gfedorkow/Micro-Whirlwind/README.md

Schematic and printed circuit KiCad design files for a hand-held Whirlwind emulator based on the Raspberry Pi
