gfedorkow/Micro-Whirlwind/Notes/RasPi5-Hardware-Notes.odt

RasPi Connector Pinout

Pin | Name | To/From Pi | owner | Use
1 | 3.3V | From | | -
2 | 5V | From | | -
3 | GPIO2 / SDA1 | BiDir | Both | I2C SDA
4 | 5V | From | | -
5 | GPIO3 / SCL1 | From | Both | I2C SCL
6 | GND | From | | -
7 | GPIO4 | To | RG | isGun1On – signals that the Gun1 trigger is pulled
8 | GPIO14, TXD
9 | GND | From | | -
10 | GPIO15, RXD | To
11 | GPIO17 | ? | RG | gfx doMove;
12 | GPIO18 | From | RG | enZ1 – Scope 1 Intensity
13 | GPIO27 | To | RG | isButton – application interrupt signal
14 | GND | From | | -
15 | GPIO22 | From | RG | gfx doDraw
16 | GPIO23 | From | RG | enZ2 – Scope 2 Intensity
17 | 3.3V | From | | -
18 | GPIO24 | To | RG | isGun2Pulse – single pulse per trigger pull
19 | GPIO10 / SPI-MOSI | From | RG | SPI MOSI
20 | GND | From | | -
21 | GPIO9 / SPI-MISO | To | RG | SPI-MISO
22 | GPIO25 | To | RG | isGun1Pulse – single pulse per trigger pull
23 | GPIO11 SPI-SCLK | From | RG | SPI-CLK
24 | GPIO8 / SPI_CE0 | From | RG | SPI Select for DAC
25 | GND | To | | -
26 | GPIO7 / SPI-CE1 | To | RG | isGun2On – signals that the Gun2 trigger is pulled
27 | ID_SD | | | -
28 | ID_SC | | | -
29 | GPIO5 | BiDir | RG | GPIO05 – toggle switch
30 | GND | From | | -
31 | GPIO6 | BiDir | RG | GPIO06 – toggle switch
32 | GPIO12 | | | Spare!
33 | GPIO13 | To | GF | Power control input
34 | GND | | | -
35 | GPIO19 | From | GF | Power control output
36 | GPIO16 | To | GF | Key Scanner Interrupt
37 | GPIO26 | To | GF | Key Scanner Reset
38 | GPIO20 | BiDir | RG | GPIO20 – toggle switch
39 | GND | From | | -
40 | GPIO21 | BiDir | RG | GPIO21 – toggle switch

Address Map

Lights / IS31FL Drivers

I2C | Row Addr aka Frame | Bits | Ref Des | Function
74 | 0 | 7:0 | | MAR
| | 15:8

Power shutdown button

https://forums.raspberrypi.com/viewtopic.php?t=371129

dtoverlay=gpio-shutdown,gpio_pin=15

gpio=23=op,dh

RetArsonFD (https://forums.raspberrypi.com/memberlist.php?mode=viewprofile&u=360628&sid=c77f70ce02d40ed3e05a03a25251eb3e)

Posts: 9 (https://forums.raspberrypi.com/search.php?author_id=360628&sid=c77f70ce02d40ed3e05a03a25251eb3e)

Joined: Sun Jan 03, 2021 3:49 pm

### Re: How to do a soft shutdown on headless Pi? (https://forums.raspberrypi.com/viewtopic.php?t=306320#p1832670)

Mon Mar 08, 2021 12:58 pm (https://forums.raspberrypi.com/viewtopic.php?p=1832670&sid=c77f70ce02d40ed3e05a03a25251eb3e#p1832670)

RonR (https://forums.raspberrypi.com/memberlist.php?mode=viewprofile&u=186692&sid=c77f70ce02d40ed3e05a03a25251eb3e) wrote: ↑ (https://forums.raspberrypi.com/viewtopic.php?p=1832522&sid=c77f70ce02d40ed3e05a03a25251eb3e#p1832522)

Mon Mar 08, 2021 4:46 am

Another option is to connect a Normally Open (NO) Single Pole Single Throw (SPST) momentary pushbutton switch to GPIO header pins 5 and 6 on the Raspberry Pi and add the following line to /boot/config.txt:

Code: Select all (https://forums.raspberrypi.com/viewtopic.php?t=306320#)

dtoverlay=gpio-shutdown

Pressing the button on a running system will initiate a graceful shutdown (shutdown -h now). Watch for the green LED to blink 10 times and it's safe to turn off the power. If you don't turn off the power, pressing the button again will restart the system.

(https://forums.raspberrypi.com/memberlist.php?mode=viewprofile&u=119273&sid=c77f70ce02d40ed3e05a03a25251eb3e)

B.Goode (https://forums.raspberrypi.com/memberlist.php?mode=viewprofile&u=119273&sid=c77f70ce02d40ed3e05a03a25251eb3e)

Posts: 17352 (https://forums.raspberrypi.com/search.php?author_id=119273&sid=c77f70ce02d40ed3e05a03a25251eb3e)

Joined: Mon Sep 01, 2014 4:03 pm

Location: UK

### Re: How to do a soft shutdown on headless Pi? (https://forums.raspberrypi.com/viewtopic.php?t=306320#p1832684)

Mon Mar 08, 2021 1:26 pm (https://forums.raspberrypi.com/viewtopic.php?p=1832684&sid=c77f70ce02d40ed3e05a03a25251eb3e#p1832684)

RetArsonFD (https://forums.raspberrypi.com/memberlist.php?mode=viewprofile&u=360628&sid=c77f70ce02d40ed3e05a03a25251eb3e) wrote: ↑ (https://forums.raspberrypi.com/viewtopic.php?p=1832670&sid=c77f70ce02d40ed3e05a03a25251eb3e#p1832670)

Mon Mar 08, 2021 12:58 pm

Where would I put the "dtoverlay=gpio-shutdown" command ? If I remember what I've been told, there are numbered lines in the config txt ??

No. The format of the config.txt file is documented here. It is not numbered. https://www.raspberrypi.org/documentati ... /README.md (https://www.raspberrypi.org/documentation/configuration/config-txt/README.md)


The specific details of the dtoverlay=gpio-shutdown configuration option are here - https://raw.githubusercontent.com/raspb ... ays/README

Quote from the above link:

Name: gpio-shutdown

Info: Initiates a shutdown when GPIO pin changes. The given GPIO pin

is configured as an input key that generates KEY_POWER events.

This event is handled by systemd-logind by initiating a

shutdown. Systemd versions older than 225 need an udev rule

enable listening to the input device:

ACTION!="REMOVE", SUBSYSTEM=="input", KERNEL=="event*", \

SUBSYSTEMS=="platform", DRIVERS=="gpio-keys", \

ATTRS{keys}=="116", TAG+="power-switch"

Alternatively this event can be handled also on systems without

systemd, just by traditional SysV init daemon. KEY_POWER event

(keycode 116) needs to be mapped to KeyboardSignal on console

and then kb::kbrequest inittab action which is triggered by

KeyboardSignal from console can be configured to issue system

shutdown. Steps for this configuration are:

Add following lines to the /etc/console-setup/remap.inc file:

# Key Power as special keypress

keycode 116 = KeyboardSignal

Then add following lines to /etc/inittab file:

# Action on special keypress (Key Power)

kb::kbrequest:/sbin/shutdown -t1 -a -h -P now

And finally reload configuration by calling following commands:

# dpkg-reconfigure console-setup

# service console-setup reload

# init q

This overlay only handles shutdown. After shutdown, the system

can be powered up again by driving GPIO3 low. The default

configuration uses GPIO3 with a pullup, so if you connect a

button between GPIO3 and GND (pin 5 and 6 on the 40-pin header),

you get a shutdown and power-up button. Please note that

Raspberry Pi 1 Model B rev 1 uses GPIO1 instead of GPIO3.

Load: dtoverlay=gpio-shutdown,<param>=<val>

Params: gpio_pin GPIO pin to trigger on (default 3)

For Raspberry Pi 1 Model B rev 1 set this

explicitly to value 1, e.g.:

dtoverlay=gpio-shutdown,gpio_pin=1

active_low When this is 1 (active low), a falling

edge generates a key down event and a

rising edge generates a key up event.

When this is 0 (active high), this is

reversed. The default is 1 (active low).

gpio_pull Desired pull-up/down state (off, down, up)

Default is "up".

Note that the default pin (GPIO3) has an

external pullup. Same applies for GPIO1

on Raspberry Pi 1 Model B rev 1.

debounce Specify the debounce interval in milliseconds

(default 100)
