gfedorkow/Micro-Whirlwind/KiCad-PCB/Micro-Whirlwind-Main-PCB - As-Built Dec-2024/parts-list.xlsx

vendor part # | vendor | digikey part# | mouser part # | Description
ILS TB180 40 |  |  |  | Blue LED push switch
