gfedorkow/Micro-Whirlwind/KiCad-PCB/Micro-Whirlwind-Main-PCB - As-Built Dec-2024/Micro-Whirlwind-Main-PCB-guy.xlsx

Reference | Value | Datasheet | Footprint | Qty | DNP | Digi-Key | Mouser
C1,C2,C3 | C | ~ | Capacitor_THT:C_Rect_L7.0mm_W2.5mm_P5.00mm | 3
C4 | 47uF | ~ | Capacitor_THT:CP_Radial_D5.0mm_P2.50mm | 1 |  | 478-7383-1-ND
C5,C7,C8,C9,C10,C11 | 0.1uF | ~ | Capacitor_THT:C_Rect_L7.0mm_W2.5mm_P5.00mm | 6
C6 | 47uf | ~ | Capacitor_THT:CP_Radial_D5.0mm_P2.50mm | 1
D1,D2,D3,D4,D5,D6,D7,D8,D9,D10,D11,D12,D17,D18 | LED | ~ | LED_THT:LED_D3.0mm | 14
F1 | Polyfuse | ~ | Fuse:Fuse_Bourns_MF-RG300 | 1 |  | MF-RG300-0-ND
J1,J2 | Conn_02x08_Odd_Even | https://mm.digikey.com/Volume0/opasdata/d220001/medias/docus/6025/302-S.pdf | -- mixed values -- | 2 |  | ED10523-ND, ED10535-ND straight & right-angle
J4,J8 | Conn_01x03 | https://www.molex.com/pdm_docs/sd/022122034_sd.pdf | mWW-Project-Library:PSS_3 | 2 |  | WM2712-ND
J5 | X | ~ | mWW-Project-Library:CUI_RCJ-041 | 1 |  | CP-1418-ND
J6 | Y | ~ | mWW-Project-Library:CUI_RCJ-041 | 1 |  | CP-1418-ND
J7 | Z | ~ | mWW-Project-Library:CUI_RCJ-041 | 1 |  | CP-1418-ND
J9 | RaspiGPIO40 | https://multimedia.3m.com/mws/media/330367O/3m-four-wall-header-2500-series-ts-0770.pdf | Connector_PinHeader_2.54mm:PinHeader_2x20_P2.54mm_Vertical | 1 |  | MHC40E-ND
L1,LCD1,mD1,mD2,mD3,mD4,mD5,mD6,mD7,mD8,mD9,mD10,mD11,mD12,mD13,mD14,mD15,mD16,mD17,mD18,mD19,mD20,U7 | ~ |  | -- mixed values -- | 23 |  | Elecrow LCD DigiKey part = 5131-DIS00005R-ND
R1,R2,R3,R4,R5,R6,R7,R8 | R | ~ | mWW-Project-Library:SM-1206B | 8
R9,R10 | 6.8k | ~ | mWW-Project-Library:SM-1206B | 2
RV1,RV2 | 10k | ~ | Potentiometer_THT:Potentiometer_Bourns_PTV09A-2_Single_Horizontal | 2 |  | 118-PTV09A-2015U-B103-ND
S3,S4 | RA_Push | https://www.ckswitches.com/media/1457/ksa_ksl.pdf | mWW-Project-Library:SW_KSA0V311LFTR_CNK-RA-pushbutton | 2 |  | CKN10736-ND
SW1,SW2,SW3,SW4,SW5,SW18,SW19,SW20,SW21,SW22 | mSW_Push_LEDx8 | https://www.ckswitches.com/media/2865/ils.pdf | mWW-Project-Library:mILS-TB-140-SW_PUSH_and_LED_6mm_x8 | 10 |  | 108-ILSTB18040-ND
 |  |  | white square cap |  |  | 108-ILSCAPS757502-ND
 |  |  | round switch cap |  |  | 108-ILSCAPR0691-ND
SW6,SW7,SW8,SW9,SW10,SW11,SW12,SW13,SW14,SW15,SW23,SW24,SW28,SW29,SW30,SW31,SW32,SW33,SW34,SW35,SW36,SW37,SW38,SW39,SW40 | SW_Push_LED | ~ | -- mixed values -- | 25
SW25 | SW_SPDT_MSM |  | mWW-Project-Library:SPDT-Toggle-Right-Angle-Vertical | 1 |  | can't find one… | https://www.mouser.com/ProductDetail/Apem/5239AB?qs=RvImgz6LUSWFeoa22Cgj3Q%3D%3D
U1,U2,U5 | IS31FL3731-SA | http://www.issi.com/WW/pdf/31FL3731.pdf | Package_SO:SSOP-28_5.3x10.2mm_P0.65mm | 3
U3,U4 | TCA8418RTWR |  | mWW-Project-Library:QFN50P400X400X80-25N | 2
U6 | LTC4316IDD_PBF |  | mWW-Project-Library:DFN-10_DD | 1 |  | 505-LTC4316CMS#PBF-ND
U8 | RasPi Outline |  | mWW-Project-Library:RasPi-Outline | 1 |  | n/a
U9 | D_to_A_Outline |  | mWW-Project-Library:D_to_A_Outline | 1 |  | n/a
U10 | 4001 | http://www.intersil.com/content/dam/Intersil/documents/cd40/cd4000bms-01bms-02bms-25bms.pdf | Package_SO:SOIC-14_3.9x8.7mm_P1.27mm | 1 |  | 296-3500-5-ND
 | cd4106BM |  | SOIC - schmidt trigger |  |  | 296-25935-5-ND
 | NKK B12JP spdt toggle sw | https://www.nkkswitches.com/pdf/Btoggles.pdf |  |  |  | 360-3783-ND
 | IRF5305PBF |  | p-channel mosfet |  |  | 4518-IRF5305PBF-ND
 | 3.5 mm audio jack | https://www.sameskydevices.com/product/resource/sj1-353xng.pdf |  |  |  | CP1-3535NG-ND
