gfedorkow/Micro-Whirlwind/Data-Sheets/IF31FL3731_LED_Wiring.pdf

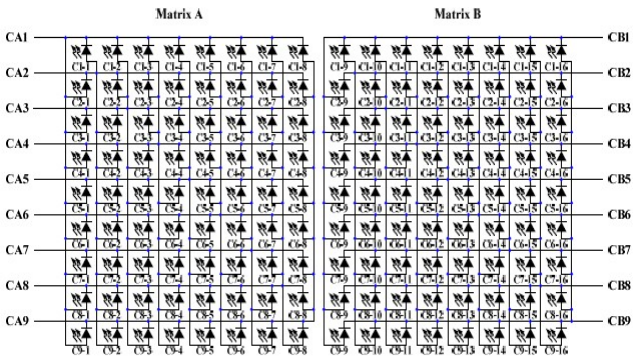
[picture p4: figure]
