gfedorkow/Micro-Whirlwind/KiCad-PCB/panel-sketch-8mm-keys.pdf

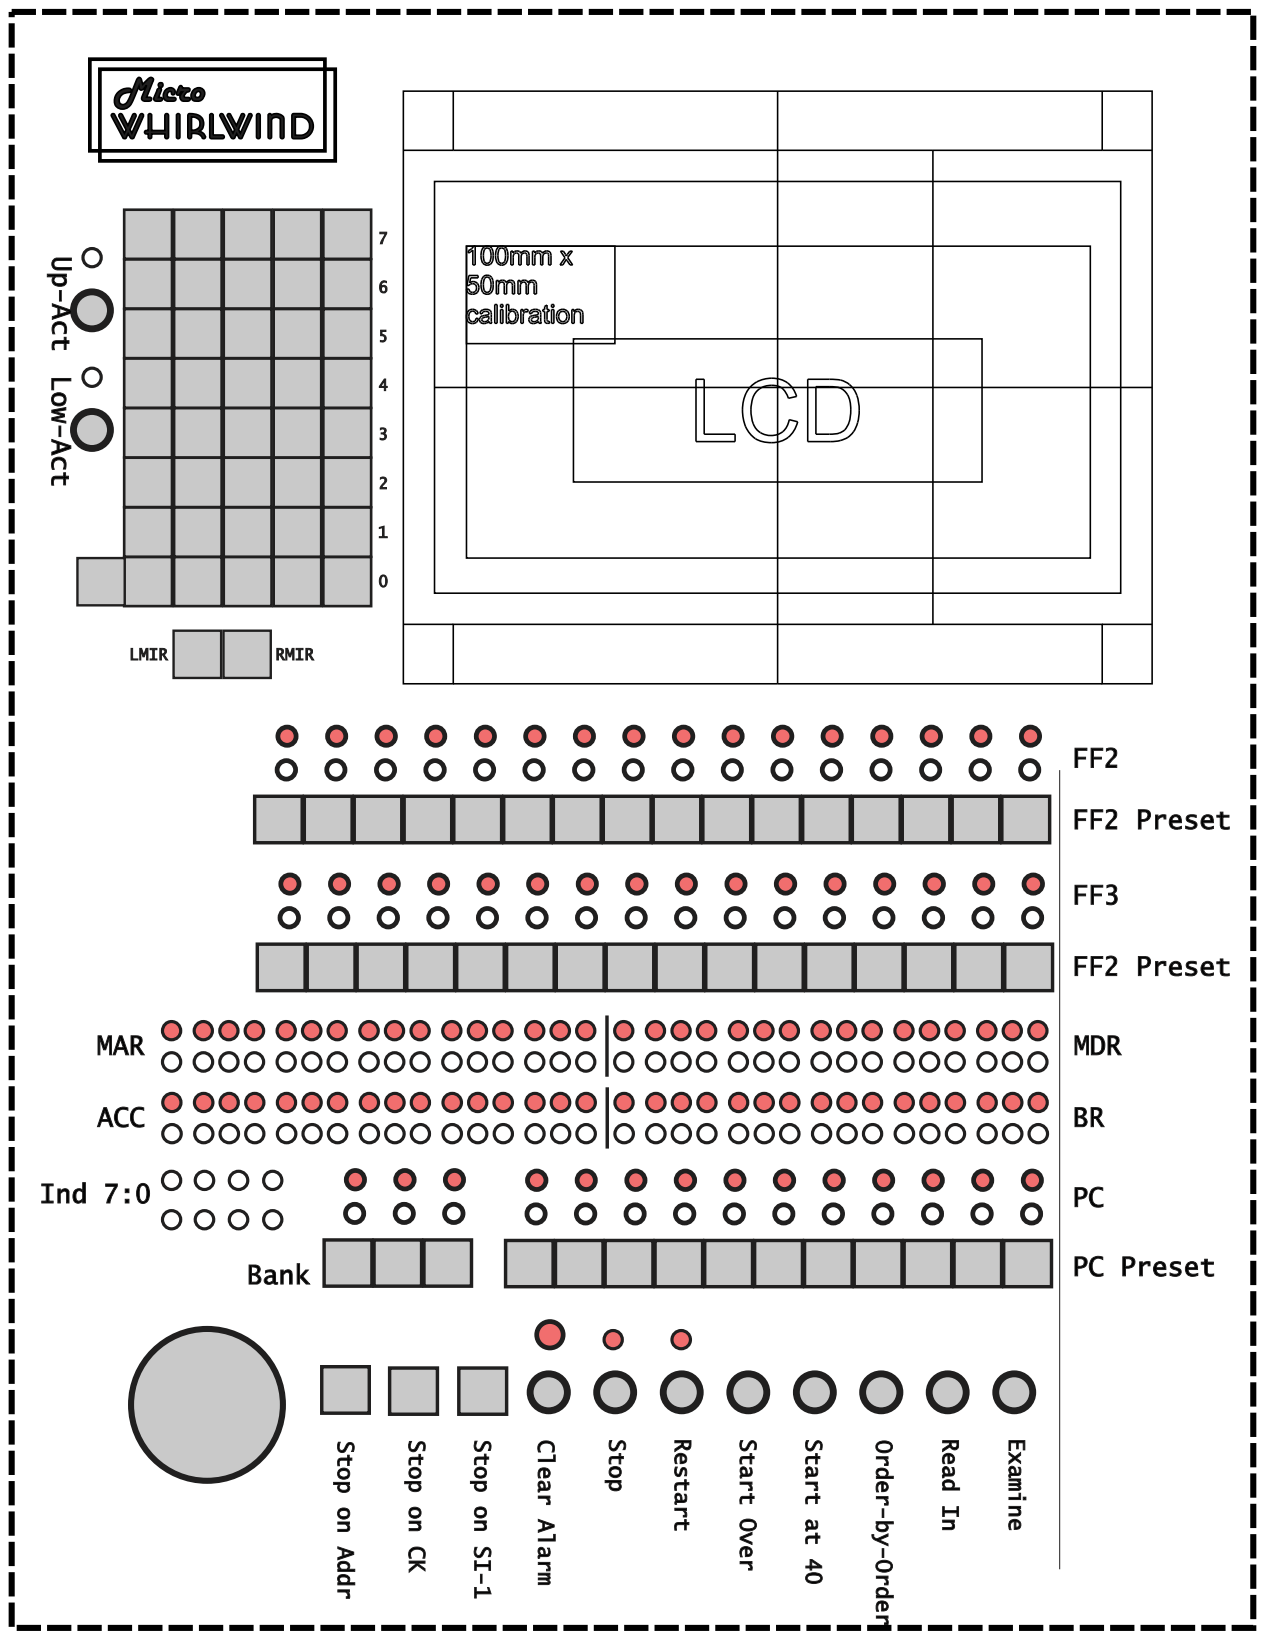
[picture p5: page 1]
