gfedorkow/Micro-Whirlwind/KiCad-PCB/Micro-Whirlwind-Dress-Panel/trial-silk-Dec14-2024.pdf

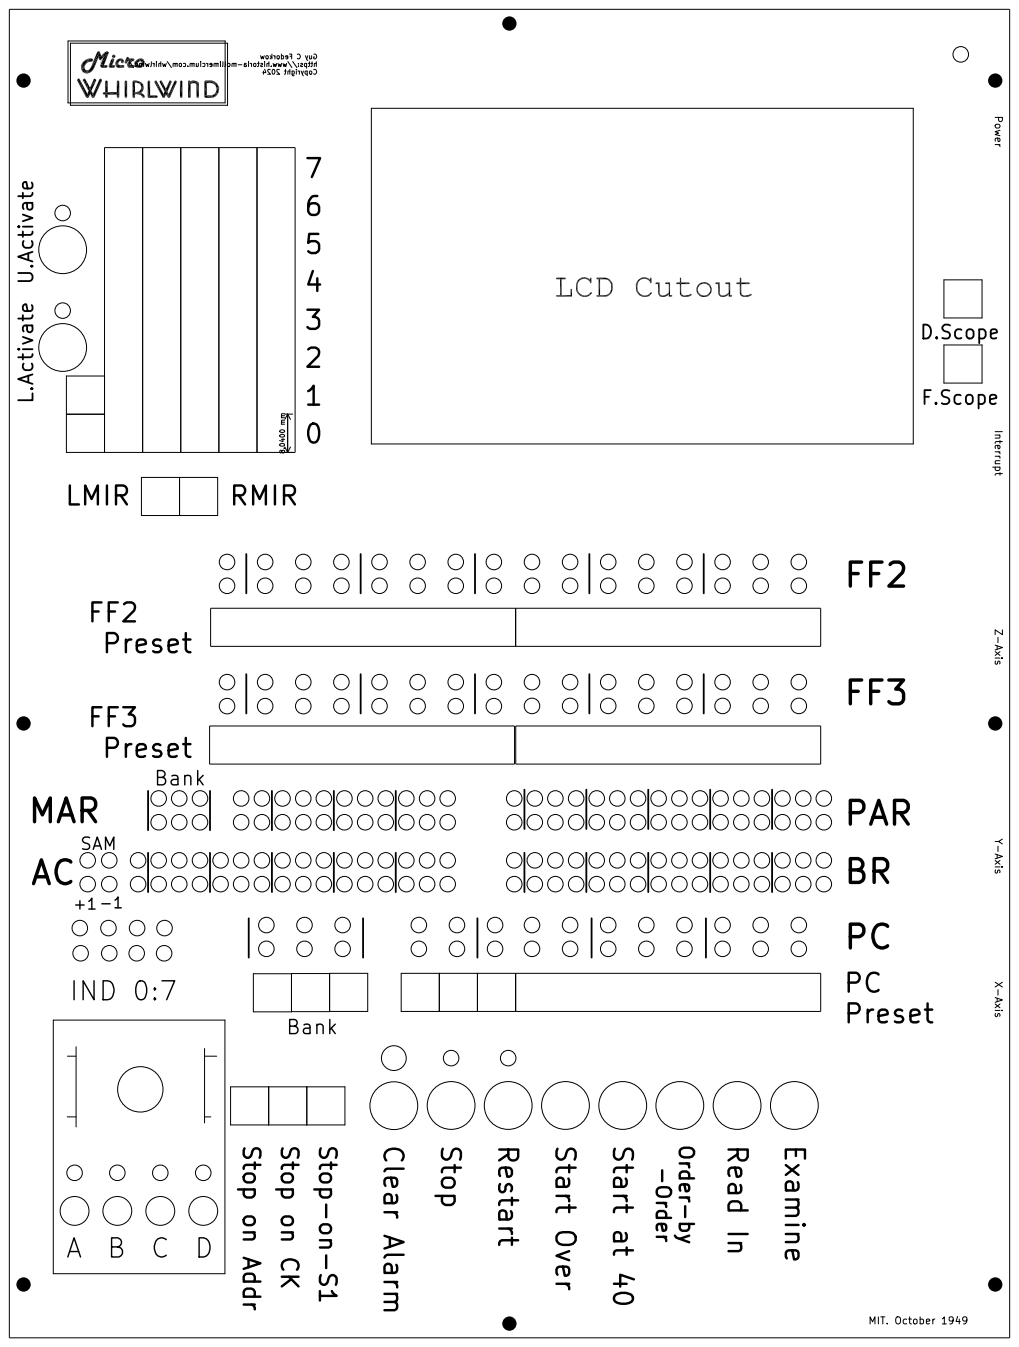
[picture p6: page 1]
