gfedorkow/Micro-Whirlwind/KiCad-PCB/Micro-Whirlwind-Dress-Panel/trial-silk-Dec15-2024.pdf

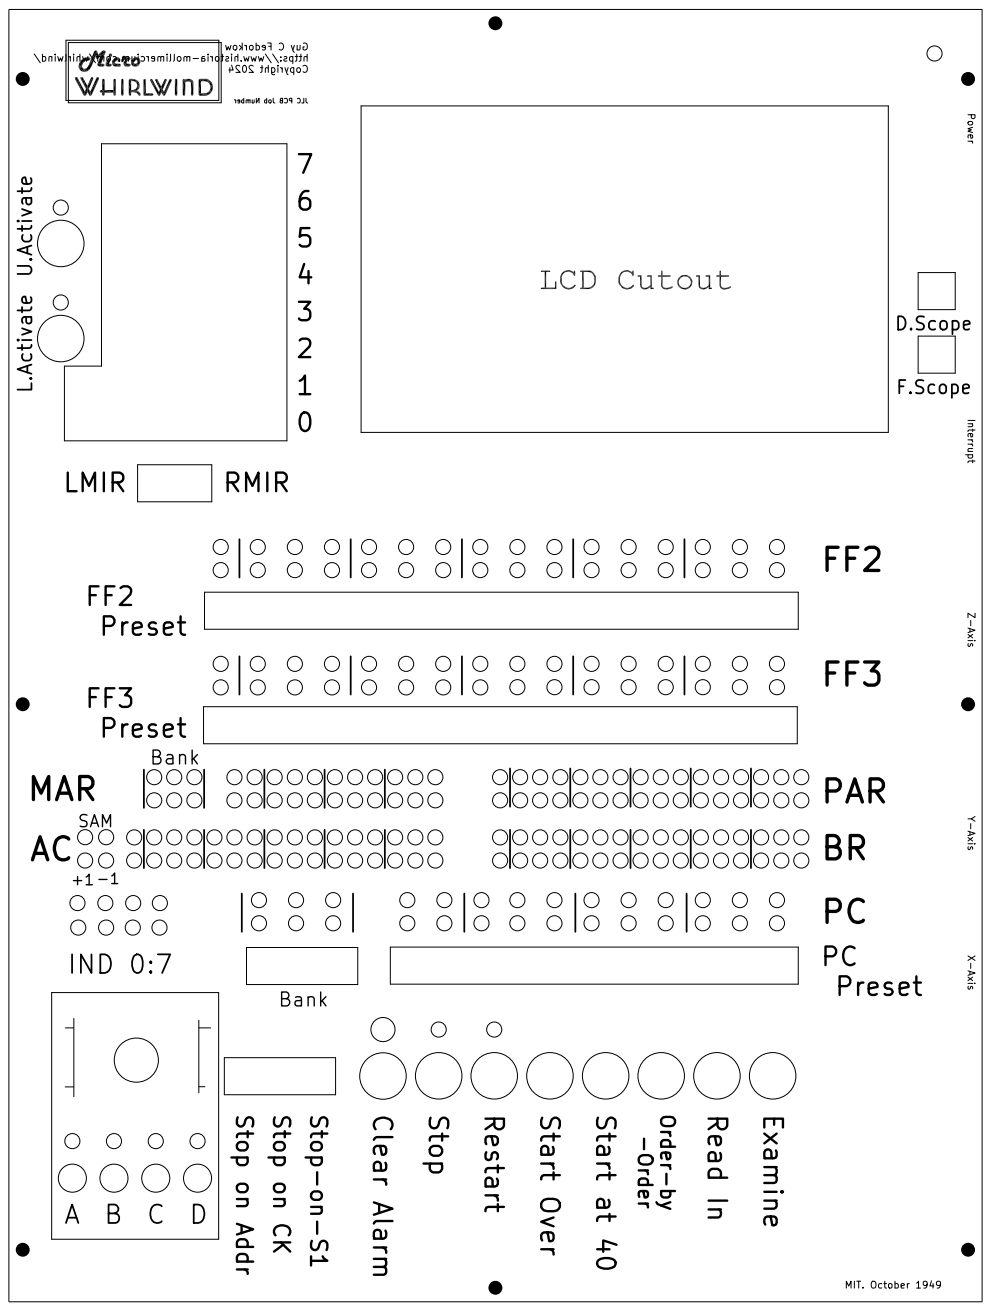
[picture p7: page 1]
