gfedorkow/Micro-Whirlwind/KiCad-PCB/Micro-Whirlwind-Main-PCB/trial-silk-screen-dec08-2024.pdf

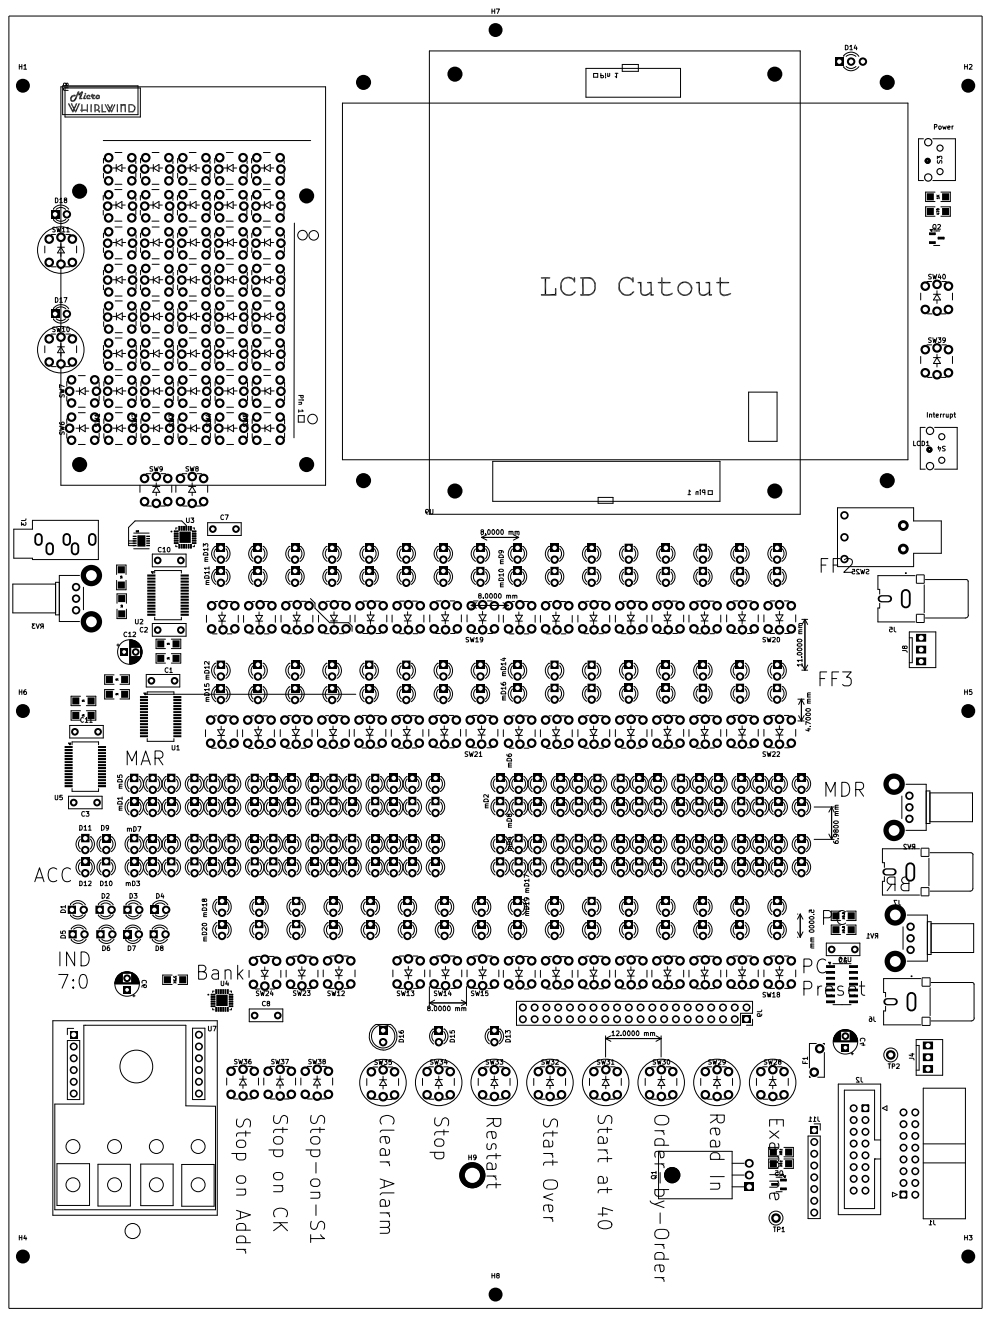
[picture p8: page 1]
