gfedorkow/Micro-Whirlwind/KiCad-PCB/Micro-Whirlwind-Main-PCB/trial-silk-screen-dec15-2024.pdf

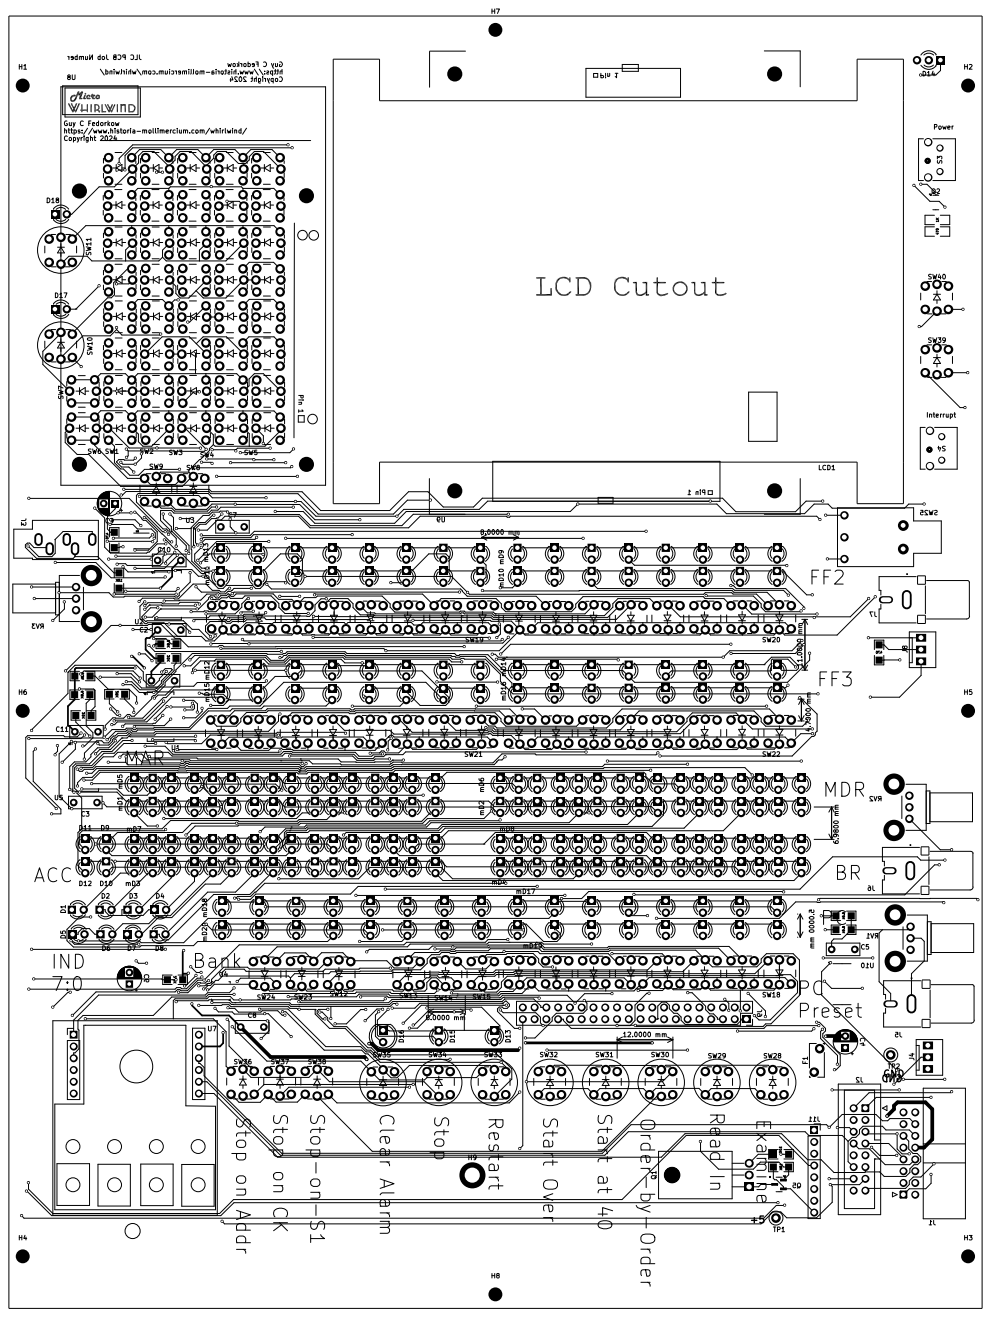
[picture p9: page 1]
