gfedorkow/Micro-Whirlwind/KiCad-PCB/Micro-Whirlwind-Rotary-Daughter/rotary-daughter-silk-dec12-2024.pdf

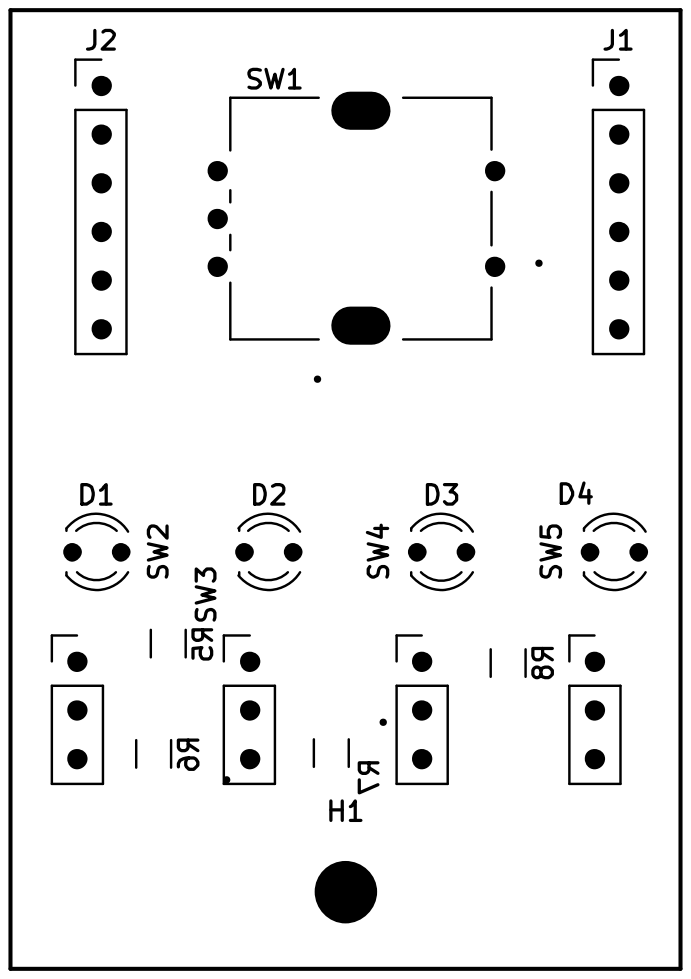
[picture p10: page 1]
