gfedorkow/Micro-Whirlwind/KiCad-PCB/Micro-Whirlwind-Main-PCB - As-Built Dec-2024/Micro-Whirlwind-Main-PCB.kicad_pcb

## KiCad design KiCad-PCB/Micro-Whirlwind-Main-PCB - As-Built Dec-2024/Micro-Whirlwind-Main-PCB.kicad_pcb (2025-10-29)

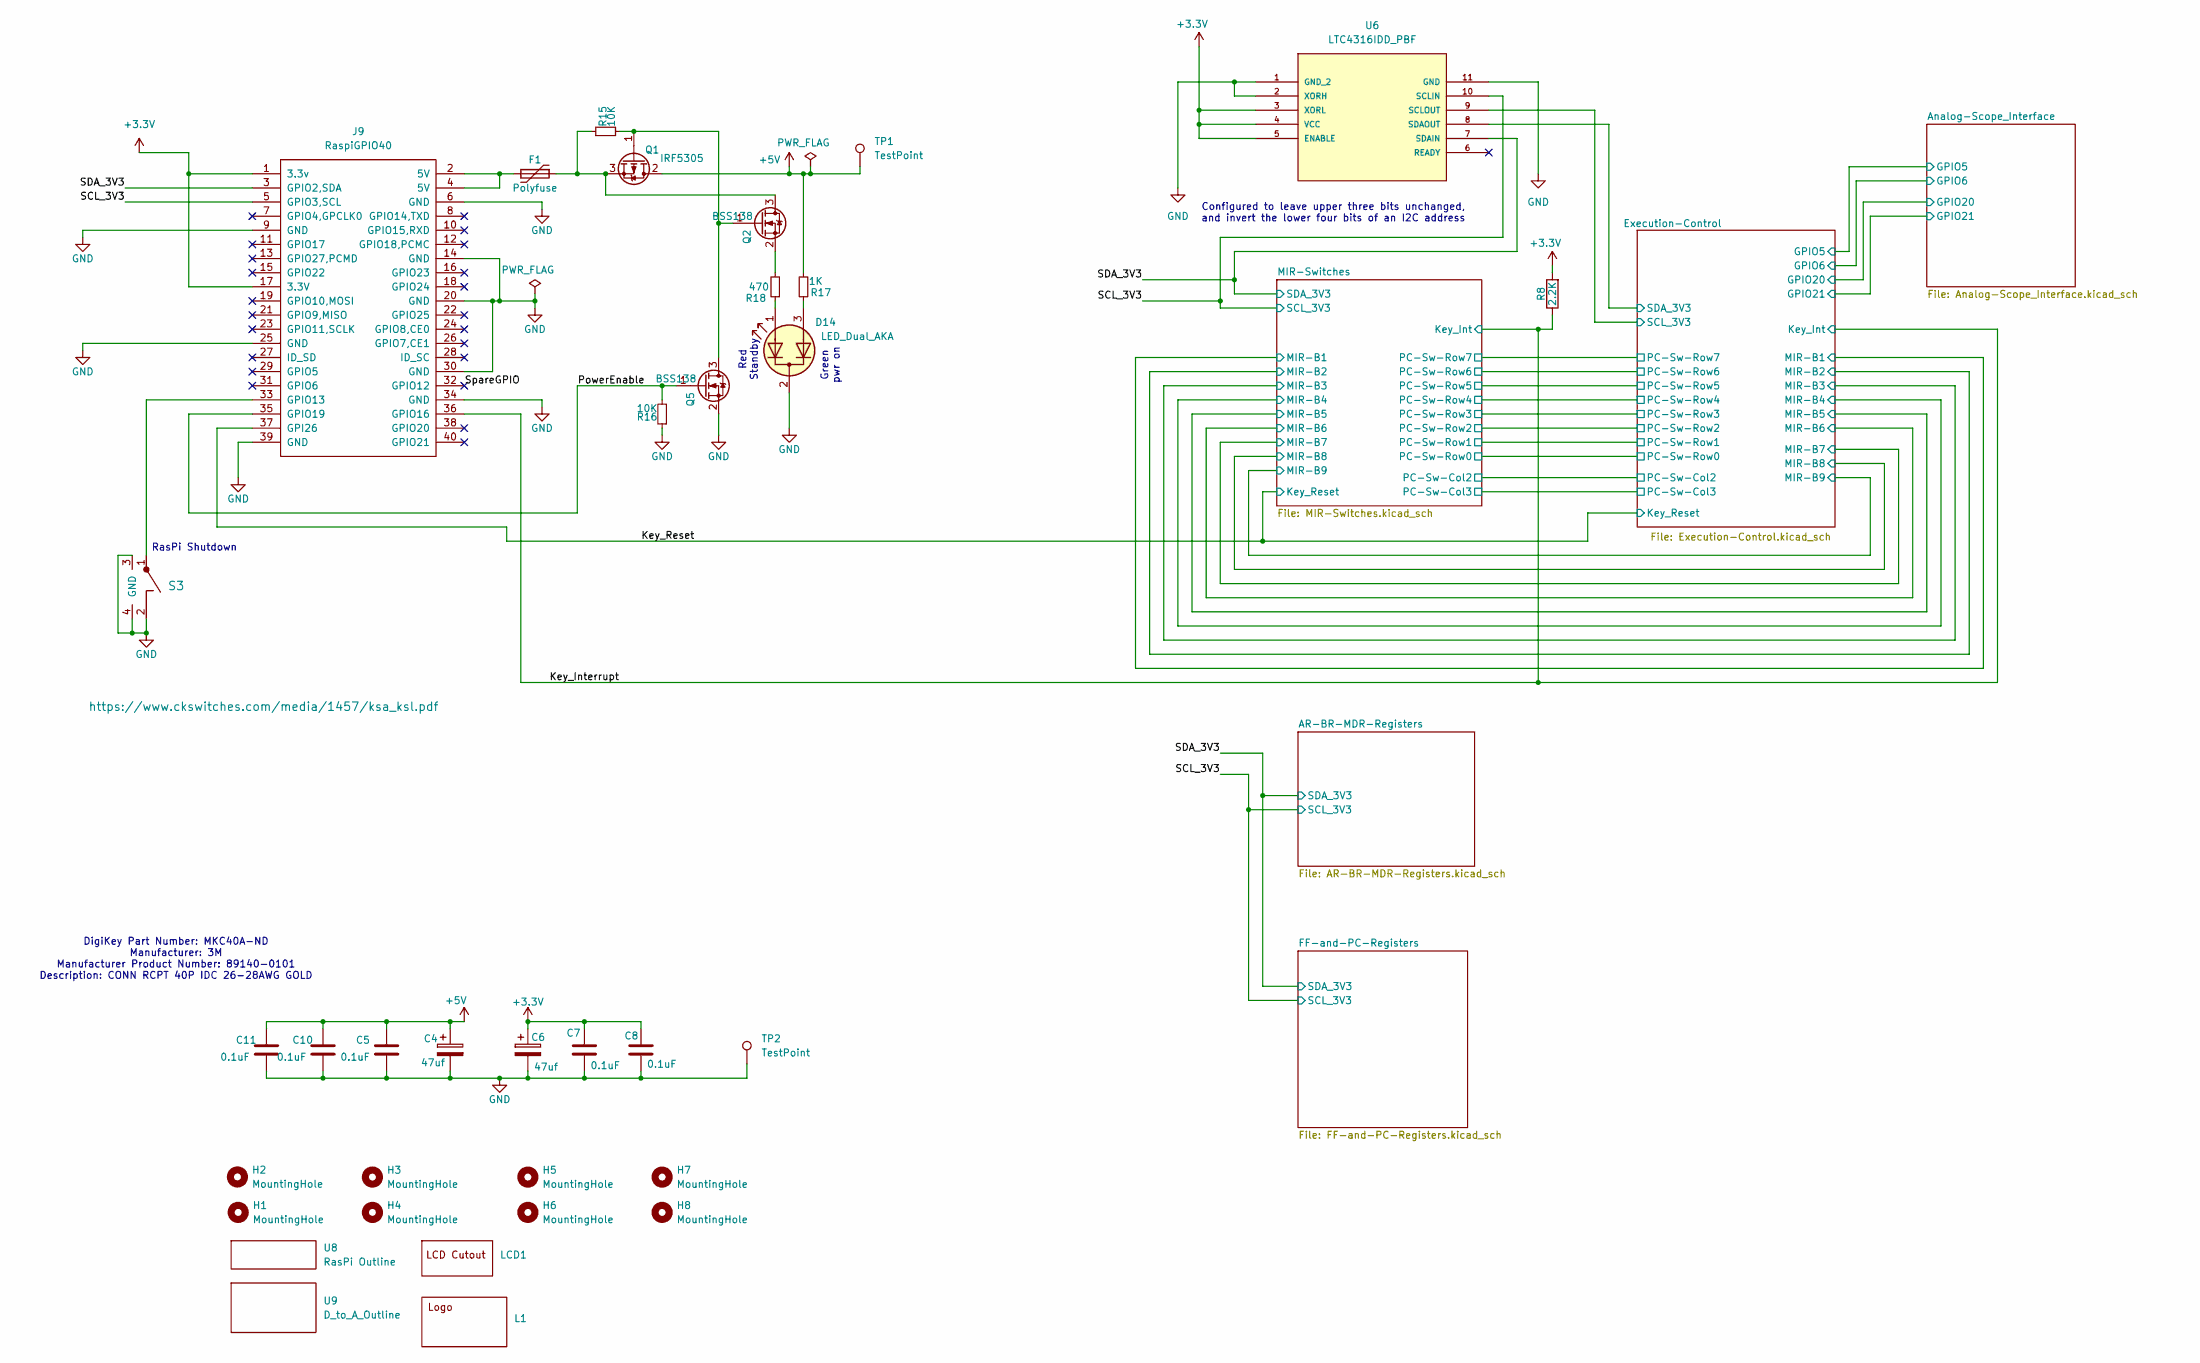
[picture p11: schematic Micro-Whirlwind-Main-PCB.kicad_sch]

Parts:
C4, C6: 47uf; CP_Radial_D5.0mm_P2.50mm
C5, C7, C8, C10, C11: 0.1uF; C_Rect_L7.0mm_W2.5mm_P5.00mm
D14: LED_Dual_AKA; LED_D3.0mm-3
F1: Polyfuse; Fuse_Bourns_MF-RG300
H1, H2, H3, H4, H5, H6, H7, H8: MountingHole; MountingHole_4_40_body
J9: RaspiGPIO40; PinHeader_2x20_P2.54mm_Vertical
L1: Logo-Large
LCD1: LCD-Cutout
Q1: IRF5305; TO-220-3_Horizontal_TabDown
Q2, Q5: BSS138; SOT-23
R8: 2.2K; SM-1206B
R15, R16: 10K; SM-1206B
R17: 1K; SM-1206B
R18: 470; SM-1206B
S3: RA_Push; SW_KSA0V311LFTR_CNK-RA-pushbutton
TP1, TP2: TestPoint; TestPoint_Loop_D2.50mm_Drill1.0mm
U6: LTC4316IDD_PBF; DFN-10_DD-with-clearance; MANUFACTURER_PART_NUMBER ltc4316idd#pbf
U8: RasPi Outline; RasPi-Outline
U9: D_to_A_Outline

Connections:
+3.3V: C6.1, C7.1, C8.1, J9.1 (3.3v), J9.17 (3.3V), R8.2, U6.3 (XORL), U6.4 (VCC), U6.5 (ENABLE); also elsewhere on the board
+5V: C4.1, C5.1, C10.1, C11.1, Q1.2 (D), R17.2, TP1.1; also elsewhere on the board
/Execution-Control/SCL_3V3: U6.9 (SCLOUT); also elsewhere on the board
/Execution-Control/SDA_3V3: U6.8 (SDAOUT); also elsewhere on the board
/Key_Interrupt: J9.36 (GPIO16), R8.1; also elsewhere on the board
/Key_Reset: J9.37 (GPI26); also elsewhere on the board
/PowerEnable: J9.35 (GPIO19), Q5.1 (G), R16.2
/SCL_3V3: J9.5 (GPIO3,SCL), U6.10 (SCLIN); also elsewhere on the board
/SDA_3V3: J9.3 (GPIO2,SDA), U6.7 (SDAIN); also elsewhere on the board
/SpareGPIO: J9.32 (GPIO12)
GND: C4.2, C5.2, C6.2, C7.2, C8.2, C10.2, C11.2, D14.2 (K), J9.6 (GND), J9.9 (GND), J9.14 (GND), J9.20 (GND), J9.25 (GND), J9.30 (GND), J9.34 (GND), J9.39 (GND), Q5.2 (S), R16.1, S3.2, S3.3 (GND), S3.4, TP2.1, U6.1 (GND_2), U6.2 (XORH), U6.11 (GND); also elsewhere on the board
unnamed: D14.1 (A1), R18.1
unnamed: D14.3 (A2), R17.1
unnamed: F1.2, J9.2 (5V), J9.4 (5V)
unnamed: J9.33 (GPIO13), S3.1
unnamed: Q1.1 (G), Q2.1 (G), Q5.3 (D), R15.2
unnamed: F1.1, Q1.3 (S), Q2.3 (D), R15.1
unnamed: Q2.2 (S), R18.2

Notes on the sheet:
Green pwr on
DigiKey Part Number: MKC40A-ND Manufacturer: 3M Manufacturer Product Number: 89140-0101 Description: CONN RCPT 40P IDC 26-28AWG GOLD
Configured to leave upper three bits unchanged, and invert the lower four bits of an I2C address
Red Standby
RasPi Shutdown

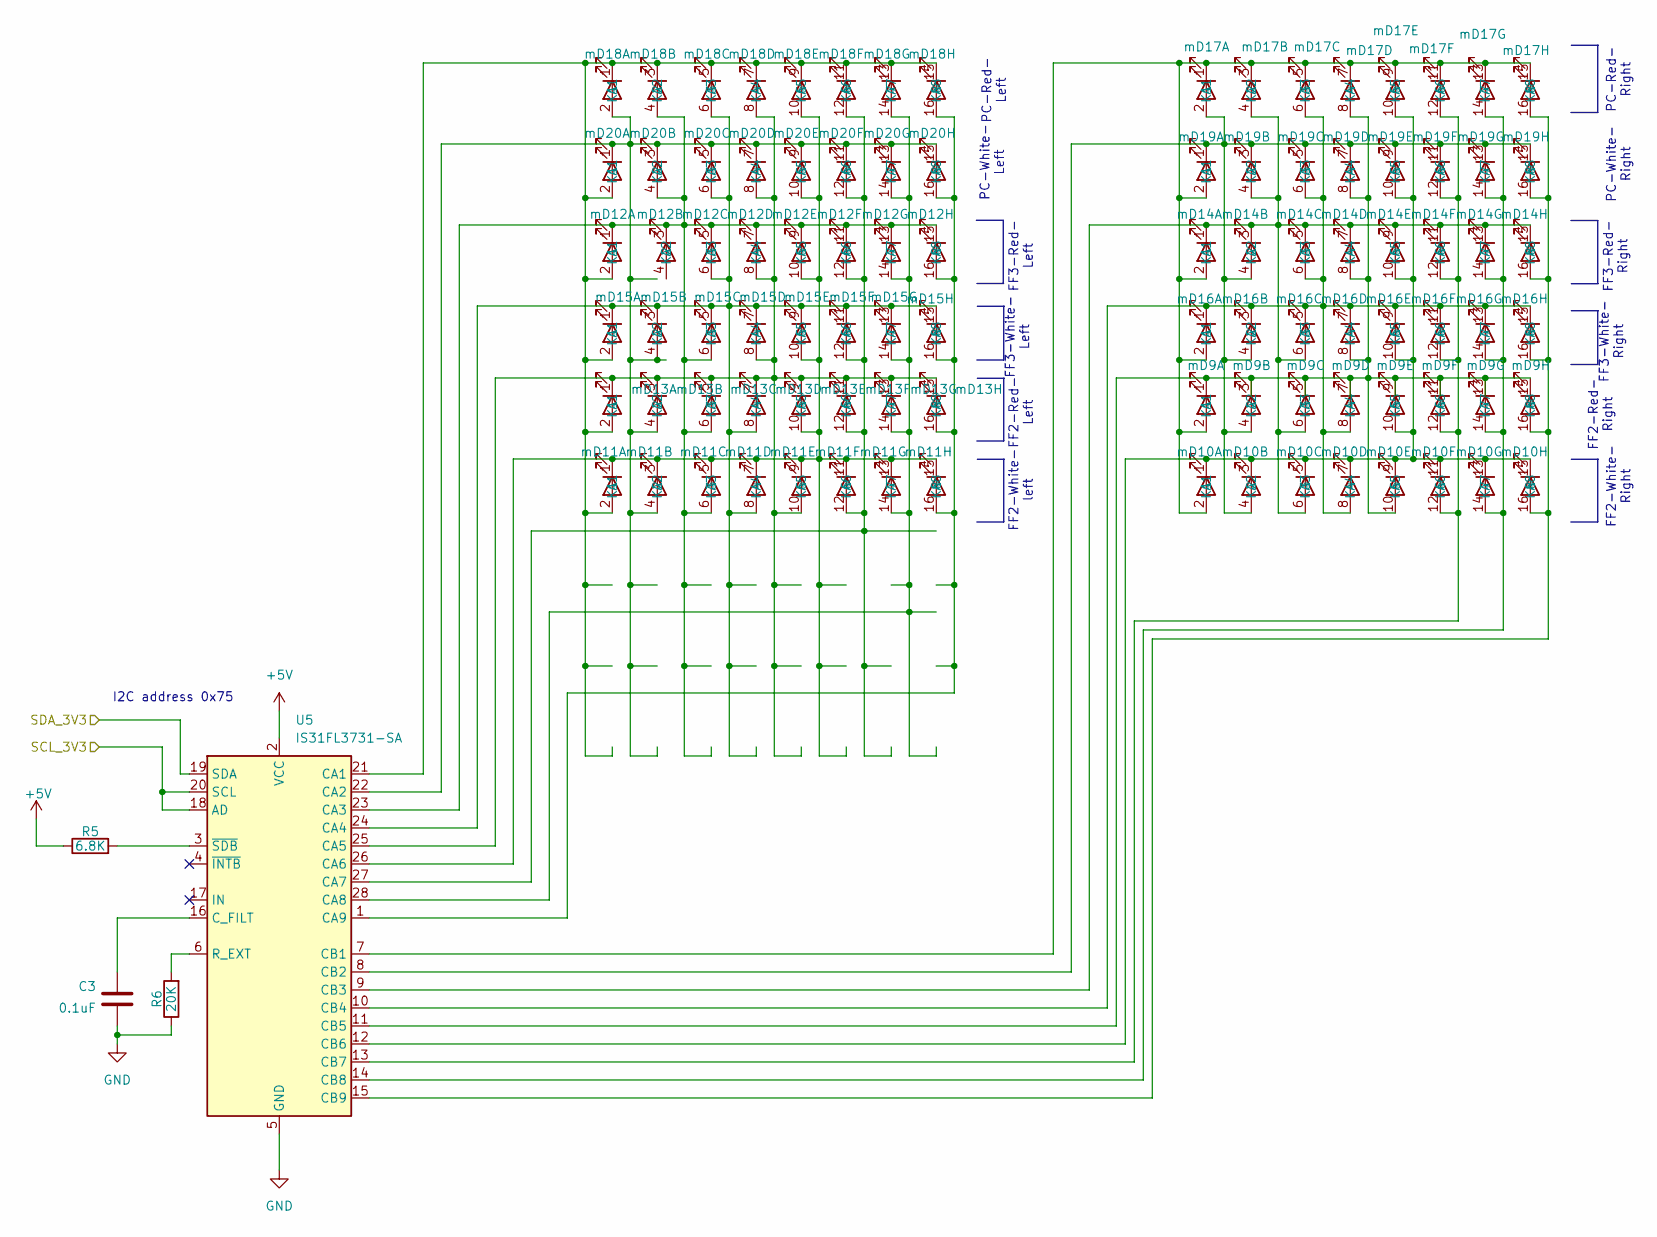
[picture p12: schematic FF-and-PC-Registers.kicad_sch]

Parts:
C3: 0.1uF; C_Rect_L7.0mm_W2.5mm_P5.00mm
R5: 6.8K; SM-1206B
R6: 20K; SM-1206B
U5: IS31FL3731-SA; SSOP-28_5.3x10.2mm_P0.65mm
mD9, mD10, mD11, mD12, mD13, mD14, mD15, mD16, mD17, mD18, mD19, mD20: LED_D3.0mm_8x_bank

Connections:
+5V: R5.1, U5.2 (VCC); also elsewhere on the board
/SCL_3V3: U5.18 (AD), U5.20 (SCL); also elsewhere on the board
/SDA_3V3: U5.19 (SDA); also elsewhere on the board
GND: C3.2, R6.1, U5.5 (GND); also elsewhere on the board
unnamed: U5.21 (CA1), mD11.2 (A1), mD12.2 (A1), mD13.2 (A1), mD15.2 (A1), mD18.1 (K1), mD18.3 (K2), mD18.5 (K3), mD18.7 (K4), mD18.9 (K5), mD18.11 (K6), mD18.13 (K7), mD18.15 (K8), mD20.2 (A1)
unnamed: U5.22 (CA2), mD11.4 (A2), mD13.4 (A2), mD15.4 (A2), mD18.2 (A1), mD20.1 (K1), mD20.3 (K2), mD20.5 (K3), mD20.7 (K4), mD20.9 (K5), mD20.11 (K6), mD20.13 (K7), mD20.15 (K8)
unnamed: U5.23 (CA3), mD11.6 (A3), mD12.1 (K1), mD12.3 (K2), mD12.5 (K3), mD12.7 (K4), mD12.9 (K5), mD12.11 (K6), mD12.13 (K7), mD12.15 (K8), mD13.6 (A3), mD15.6 (A3), mD18.4 (A2), mD20.4 (A2)
unnamed: U5.24 (CA4), mD11.8 (A4), mD12.6 (A3), mD13.8 (A4), mD15.1 (K1), mD15.3 (K2), mD15.5 (K3), mD15.7 (K4), mD15.9 (K5), mD15.11 (K6), mD15.13 (K7), mD15.15 (K8), mD18.6 (A3), mD20.6 (A3)
unnamed: U5.25 (CA5), mD11.10 (A5), mD12.8 (A4), mD13.1 (K1), mD13.3 (K2), mD13.5 (K3), mD13.7 (K4), mD13.9 (K5), mD13.11 (K6), mD13.13 (K7), mD13.15 (K8), mD15.8 (A4), mD18.8 (A4), mD20.8 (A4)
unnamed: U5.26 (CA6), mD11.1 (K1), mD11.3 (K2), mD11.5 (K3), mD11.7 (K4), mD11.9 (K5), mD11.11 (K6), mD11.13 (K7), mD11.15 (K8), mD12.10 (A5), mD13.10 (A5), mD15.10 (A5), mD18.10 (A5), mD20.10 (A5)
unnamed: U5.27 (CA7), mD11.12 (A6), mD12.12 (A6), mD13.12 (A6), mD15.12 (A6), mD18.12 (A6), mD20.12 (A6)
unnamed: U5.28 (CA8), mD11.14 (A7), mD12.14 (A7), mD13.14 (A7), mD15.14 (A7), mD18.14 (A7), mD20.14 (A7)
unnamed: U5.1 (CA9), mD11.16 (A8), mD12.16 (A8), mD13.16 (A8), mD15.16 (A8), mD18.16 (A8), mD20.16 (A8)
unnamed: U5.7 (CB1), mD9.2 (A1), mD10.2 (A1), mD14.2 (A1), mD16.2 (A1), mD17.1 (K1), mD17.3 (K2), mD17.5 (K3), mD17.7 (K4), mD17.9 (K5), mD17.11 (K6), mD17.13 (K7), mD17.15 (K8), mD19.2 (A1)
unnamed: U5.8 (CB2), mD9.4 (A2), mD10.4 (A2), mD14.4 (A2), mD16.4 (A2), mD17.2 (A1), mD19.1 (K1), mD19.3 (K2), mD19.5 (K3), mD19.7 (K4), mD19.9 (K5), mD19.11 (K6), mD19.13 (K7), mD19.15 (K8)
unnamed: U5.9 (CB3), mD9.6 (A3), mD10.6 (A3), mD14.1 (K1), mD14.3 (K2), mD14.5 (K3), mD14.7 (K4), mD14.9 (K5), mD14.11 (K6), mD14.13 (K7), mD14.15 (K8), mD16.6 (A3), mD17.4 (A2), mD19.4 (A2)
unnamed: U5.10 (CB4), mD9.8 (A4), mD10.8 (A4), mD14.6 (A3), mD16.1 (K1), mD16.3 (K2), mD16.5 (K3), mD16.7 (K4), mD16.9 (K5), mD16.11 (K6), mD16.13 (K7), mD16.15 (K8), mD17.6 (A3), mD19.6 (A3)
unnamed: U5.11 (CB5), mD9.1 (K1), mD9.3 (K2), mD9.5 (K3), mD9.7 (K4), mD9.9 (K5), mD9.11 (K6), mD9.13 (K7), mD9.15 (K8), mD10.10 (A5), mD14.8 (A4), mD16.8 (A4), mD17.8 (A4), mD19.8 (A4)
unnamed: U5.12 (CB6), mD9.10 (A5), mD10.1 (K1), mD10.3 (K2), mD10.5 (K3), mD10.7 (K4), mD10.9 (K5), mD10.11 (K6), mD10.13 (K7), mD10.15 (K8), mD14.10 (A5), mD16.10 (A5), mD17.10 (A5), mD19.10 (A5)
unnamed: U5.13 (CB7), mD9.12 (A6), mD10.12 (A6), mD14.12 (A6), mD16.12 (A6), mD17.12 (A6), mD19.12 (A6)
unnamed: U5.14 (CB8), mD9.14 (A7), mD10.14 (A7), mD14.14 (A7), mD16.14 (A7), mD17.14 (A7), mD19.14 (A7)
unnamed: U5.15 (CB9), mD9.16 (A8), mD10.16 (A8), mD14.16 (A8), mD16.16 (A8), mD17.16 (A8), mD19.16 (A8)
unnamed: C3.1, U5.16 (C_FILT)
unnamed: R6.2, U5.6 (R_EXT)
unnamed: R5.2, U5.3 (~SDB)

Notes on the sheet:
FF2-White- left
PC-White- Left
FF3-White- Right
I2C address 0x75
FF2-White- Right
PC-Red- Right
PC-White- Right
FF2-Red- Right
PC-Red- Left
FF3-Red- Left
FF3-Red- Right
FF2-Red- Left
FF3-White- Left

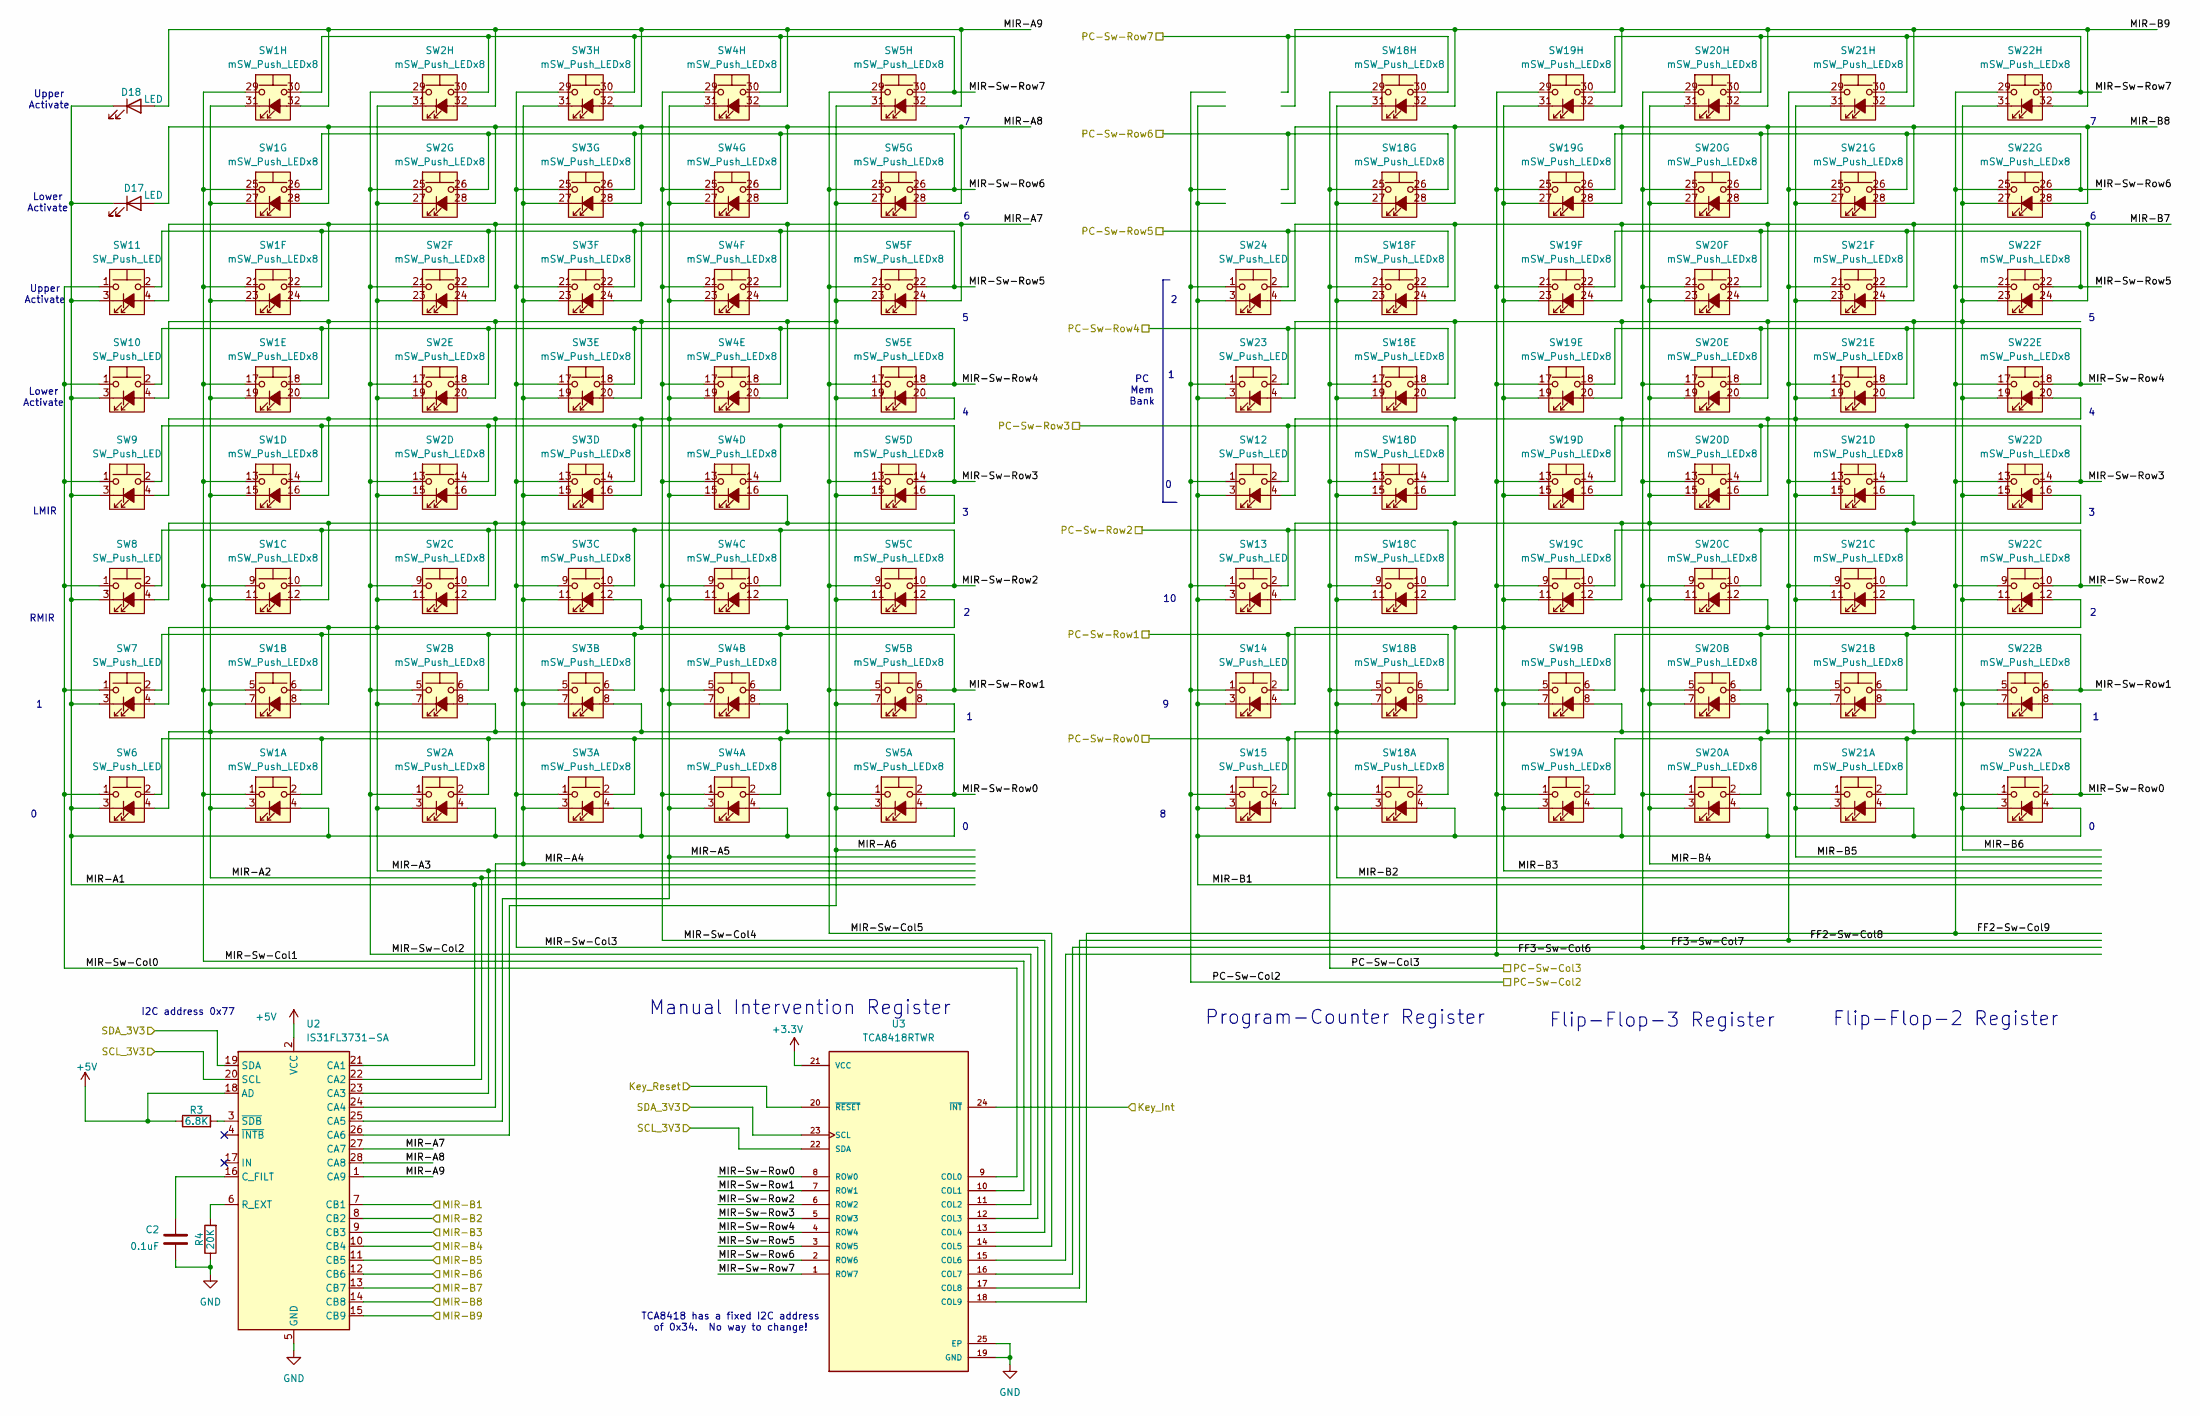
[picture p13: schematic MIR-Switches.kicad_sch]

Parts:
C2: 0.1uF; C_Rect_L7.0mm_W2.5mm_P5.00mm
D17, D18: LED; LED_D3.0mm
R3: 6.8K; SM-1206B
R4: 20K; SM-1206B
SW1, SW2, SW3, SW4, SW5, SW18, SW19, SW20, SW21, SW22: mSW_Push_LEDx8; mILS-TB-140-SW_PUSH_and_LED_6mm_x8
SW6, SW7, SW8, SW9, SW12, SW13, SW14, SW15, SW23, SW24: SW_Push_LED; ILS-TB-140-SW_PUSH_and_LED_6mm
SW10, SW11: SW_Push_LED; ILS-TB-140-SW_PUSH_LED_round
U2: IS31FL3731-SA; SSOP-28_5.3x10.2mm_P0.65mm
U3: TCA8418RTWR; QFN50P400X400X80-25N; PARTREV G

Connections:
+3.3V: U3.21 (VCC); also elsewhere on the board
+5V: R3.1, U2.2 (VCC), U2.18 (AD); also elsewhere on the board
/Execution-Control/PC-Sw-Row0: SW15.2, SW18.2 (SB); also elsewhere on the board
/Execution-Control/PC-Sw-Row1: SW14.2, SW18.6 (SB); also elsewhere on the board
/Execution-Control/PC-Sw-Row2: SW13.2, SW18.10 (SB); also elsewhere on the board
/Execution-Control/PC-Sw-Row3: SW12.2, SW18.14 (SB); also elsewhere on the board
/Execution-Control/PC-Sw-Row4: SW18.18 (SB), SW23.2; also elsewhere on the board
/Execution-Control/PC-Sw-Row5: SW18.22 (SB), SW24.2; also elsewhere on the board
/Execution-Control/PC-Sw-Row6: SW18.26 (SB); also elsewhere on the board
/Execution-Control/PC-Sw-Row7: SW18.30 (SB); also elsewhere on the board
/Key_Interrupt: U3.24 (~INT); also elsewhere on the board
/Key_Reset: U3.20 (~RESET); also elsewhere on the board
/MIR-Switches/FF2-Sw-Col8: SW21.1 (SA), SW21.5 (SA), SW21.9 (SA), SW21.13 (SA), SW21.17 (SA), SW21.21 (SA), SW21.25 (SA), SW21.29 (SA), U3.17 (COL8)
/MIR-Switches/FF2-Sw-Col9: SW22.1 (SA), SW22.5 (SA), SW22.9 (SA), SW22.13 (SA), SW22.17 (SA), SW22.21 (SA), SW22.25 (SA), SW22.29 (SA), U3.18 (COL9)
/MIR-Switches/FF3-Sw-Col6: SW19.1 (SA), SW19.5 (SA), SW19.9 (SA), SW19.13 (SA), SW19.17 (SA), SW19.21 (SA), SW19.25 (SA), SW19.29 (SA), U3.15 (COL6)
/MIR-Switches/FF3-Sw-Col7: SW20.1 (SA), SW20.5 (SA), SW20.9 (SA), SW20.13 (SA), SW20.17 (SA), SW20.21 (SA), SW20.25 (SA), SW20.29 (SA), U3.16 (COL7)
/MIR-Switches/MIR-A1: D17.1 (K), D18.1 (K), SW1.4 (A), SW2.4 (A), SW3.4 (A), SW4.4 (A), SW5.4 (A), SW6.3 (K), SW7.3 (K), SW8.3 (K), SW9.3 (K), SW10.3 (K), SW11.3 (K), U2.21 (CA1)
/MIR-Switches/MIR-A2: SW1.3 (K), SW1.7 (K), SW1.11 (K), SW1.15 (K), SW1.19 (K), SW1.23 (K), SW1.27 (K), SW1.31 (K), SW2.8 (A), SW3.8 (A), SW4.8 (A), SW5.8 (A), SW6.4 (A), U2.22 (CA2)
/MIR-Switches/MIR-A3: SW1.8 (A), SW2.3 (K), SW2.7 (K), SW2.11 (K), SW2.15 (K), SW2.19 (K), SW2.23 (K), SW2.27 (K), SW2.31 (K), SW3.12 (A), SW4.12 (A), SW5.12 (A), SW7.4 (A), U2.23 (CA3)
/MIR-Switches/MIR-A4: SW1.12 (A), SW2.12 (A), SW3.3 (K), SW3.7 (K), SW3.11 (K), SW3.15 (K), SW3.19 (K), SW3.23 (K), SW3.27 (K), SW3.31 (K), SW4.16 (A), SW5.16 (A), SW8.4 (A), U2.24 (CA4)
/MIR-Switches/MIR-A5: SW1.16 (A), SW2.16 (A), SW3.16 (A), SW4.3 (K), SW4.7 (K), SW4.11 (K), SW4.15 (K), SW4.19 (K), SW4.23 (K), SW4.27 (K), SW4.31 (K), SW5.20 (A), SW9.4 (A), U2.25 (CA5)
/MIR-Switches/MIR-A6: SW1.20 (A), SW2.20 (A), SW3.20 (A), SW4.20 (A), SW5.3 (K), SW5.7 (K), SW5.11 (K), SW5.15 (K), SW5.19 (K), SW5.23 (K), SW5.27 (K), SW5.31 (K), SW10.4 (A), U2.26 (CA6)
/MIR-Switches/MIR-A7: SW1.24 (A), SW2.24 (A), SW3.24 (A), SW4.24 (A), SW5.24 (A), SW11.4 (A), U2.27 (CA7)
/MIR-Switches/MIR-A8: D17.2 (A), SW1.28 (A), SW2.28 (A), SW3.28 (A), SW4.28 (A), SW5.28 (A), U2.28 (CA8)
/MIR-Switches/MIR-A9: D18.2 (A), SW1.32 (A), SW2.32 (A), SW3.32 (A), SW4.32 (A), SW5.32 (A), U2.1 (CA9)
/MIR-Switches/MIR-B1: SW12.3 (K), SW13.3 (K), SW14.3 (K), SW15.3 (K), SW18.4 (A), SW19.4 (A), SW20.4 (A), SW21.4 (A), SW22.4 (A), SW23.3 (K), SW24.3 (K), U2.7 (CB1); also elsewhere on the board
/MIR-Switches/MIR-B2: SW15.4 (A), SW18.3 (K), SW18.7 (K), SW18.11 (K), SW18.15 (K), SW18.19 (K), SW18.23 (K), SW18.27 (K), SW18.31 (K), SW19.8 (A), SW20.8 (A), SW21.8 (A), SW22.8 (A), U2.8 (CB2); also elsewhere on the board
/MIR-Switches/MIR-B3: SW14.4 (A), SW18.8 (A), SW19.3 (K), SW19.7 (K), SW19.11 (K), SW19.15 (K), SW19.19 (K), SW19.23 (K), SW19.27 (K), SW19.31 (K), SW20.12 (A), SW21.12 (A), SW22.12 (A), U2.9 (CB3); also elsewhere on the board
/MIR-Switches/MIR-B4: SW13.4 (A), SW18.12 (A), SW19.12 (A), SW20.3 (K), SW20.7 (K), SW20.11 (K), SW20.15 (K), SW20.19 (K), SW20.23 (K), SW20.27 (K), SW20.31 (K), SW21.16 (A), SW22.16 (A), U2.10 (CB4); also elsewhere on the board
/MIR-Switches/MIR-B5: SW12.4 (A), SW18.16 (A), SW19.16 (A), SW20.16 (A), SW21.3 (K), SW21.7 (K), SW21.11 (K), SW21.15 (K), SW21.19 (K), SW21.23 (K), SW21.27 (K), SW21.31 (K), SW22.20 (A), U2.11 (CB5); also elsewhere on the board
/MIR-Switches/MIR-B6: SW18.20 (A), SW19.20 (A), SW20.20 (A), SW21.20 (A), SW22.3 (K), SW22.7 (K), SW22.11 (K), SW22.15 (K), SW22.19 (K), SW22.23 (K), SW22.27 (K), SW22.31 (K), SW23.4 (A), U2.12 (CB6); also elsewhere on the board
/MIR-Switches/MIR-B7: SW18.24 (A), SW19.24 (A), SW20.24 (A), SW21.24 (A), SW22.24 (A), SW24.4 (A), U2.13 (CB7); also elsewhere on the board
/MIR-Switches/MIR-B8: SW18.28 (A), SW19.28 (A), SW20.28 (A), SW21.28 (A), SW22.28 (A), U2.14 (CB8); also elsewhere on the board
/MIR-Switches/MIR-B9: SW18.32 (A), SW19.32 (A), SW20.32 (A), SW21.32 (A), SW22.32 (A), U2.15 (CB9); also elsewhere on the board
/MIR-Switches/MIR-Sw-Col0: SW6.1, SW7.1, SW8.1, SW9.1, SW10.1, SW11.1, U3.9 (COL0)
/MIR-Switches/MIR-Sw-Col1: SW1.1 (SA), SW1.5 (SA), SW1.9 (SA), SW1.13 (SA), SW1.17 (SA), SW1.21 (SA), SW1.25 (SA), SW1.29 (SA), U3.10 (COL1)
/MIR-Switches/MIR-Sw-Col2: SW2.1 (SA), SW2.5 (SA), SW2.9 (SA), SW2.13 (SA), SW2.17 (SA), SW2.21 (SA), SW2.25 (SA), SW2.29 (SA), U3.11 (COL2)
/MIR-Switches/MIR-Sw-Col3: SW3.1 (SA), SW3.5 (SA), SW3.9 (SA), SW3.13 (SA), SW3.17 (SA), SW3.21 (SA), SW3.25 (SA), SW3.29 (SA), U3.12 (COL3)
/MIR-Switches/MIR-Sw-Col4: SW4.1 (SA), SW4.5 (SA), SW4.9 (SA), SW4.13 (SA), SW4.17 (SA), SW4.21 (SA), SW4.25 (SA), SW4.29 (SA), U3.13 (COL4)
/MIR-Switches/MIR-Sw-Col5: SW5.1 (SA), SW5.5 (SA), SW5.9 (SA), SW5.13 (SA), SW5.17 (SA), SW5.21 (SA), SW5.25 (SA), SW5.29 (SA), U3.14 (COL5)
/MIR-Switches/MIR-Sw-Row0: SW1.2 (SB), SW2.2 (SB), SW3.2 (SB), SW4.2 (SB), SW5.2 (SB), SW6.2, SW19.2 (SB), SW20.2 (SB), SW21.2 (SB), SW22.2 (SB), U3.8 (ROW0)
/MIR-Switches/MIR-Sw-Row1: SW1.6 (SB), SW2.6 (SB), SW3.6 (SB), SW4.6 (SB), SW5.6 (SB), SW7.2, SW19.6 (SB), SW20.6 (SB), SW21.6 (SB), SW22.6 (SB), U3.7 (ROW1)
/MIR-Switches/MIR-Sw-Row2: SW1.10 (SB), SW2.10 (SB), SW3.10 (SB), SW4.10 (SB), SW5.10 (SB), SW8.2, SW19.10 (SB), SW20.10 (SB), SW21.10 (SB), SW22.10 (SB), U3.6 (ROW2)
/MIR-Switches/MIR-Sw-Row3: SW1.14 (SB), SW2.14 (SB), SW3.14 (SB), SW4.14 (SB), SW5.14 (SB), SW9.2, SW19.14 (SB), SW20.14 (SB), SW21.14 (SB), SW22.14 (SB), U3.5 (ROW3)
/MIR-Switches/MIR-Sw-Row4: SW1.18 (SB), SW2.18 (SB), SW3.18 (SB), SW4.18 (SB), SW5.18 (SB), SW10.2, SW19.18 (SB), SW20.18 (SB), SW21.18 (SB), SW22.18 (SB), U3.4 (ROW4)
/MIR-Switches/MIR-Sw-Row5: SW1.22 (SB), SW2.22 (SB), SW3.22 (SB), SW4.22 (SB), SW5.22 (SB), SW11.2, SW19.22 (SB), SW20.22 (SB), SW21.22 (SB), SW22.22 (SB), U3.3 (ROW5)
/MIR-Switches/MIR-Sw-Row6: SW1.26 (SB), SW2.26 (SB), SW3.26 (SB), SW4.26 (SB), SW5.26 (SB), SW19.26 (SB), SW20.26 (SB), SW21.26 (SB), SW22.26 (SB), U3.2 (ROW6)
/MIR-Switches/MIR-Sw-Row7: SW1.30 (SB), SW2.30 (SB), SW3.30 (SB), SW4.30 (SB), SW5.30 (SB), SW19.30 (SB), SW20.30 (SB), SW21.30 (SB), SW22.30 (SB), U3.1 (ROW7)
/MIR-Switches/PC-Sw-Col2: SW12.1, SW13.1, SW14.1, SW15.1, SW23.1, SW24.1; also elsewhere on the board
/MIR-Switches/PC-Sw-Col3: SW18.1 (SA), SW18.5 (SA), SW18.9 (SA), SW18.13 (SA), SW18.17 (SA), SW18.21 (SA), SW18.25 (SA), SW18.29 (SA); also elsewhere on the board
/SCL_3V3: U2.20 (SCL), U3.22 (SDA); also elsewhere on the board
/SDA_3V3: U2.19 (SDA), U3.23 (SCL); also elsewhere on the board
GND: C2.2, R4.1, U2.5 (GND), U3.19 (GND), U3.25 (EP); also elsewhere on the board
unnamed: C2.1, U2.16 (C_FILT)
unnamed: R4.2, U2.6 (R_EXT)
unnamed: R3.2, U2.3 (~SDB)

Notes on the sheet:
Flip-Flop-2 Register
RMIR
I2C address 0x77
Upper Activate
Flip-Flop-3 Register
PC Mem Bank
Lower Activate
LMIR
TCA8418 has a fixed I2C address of 0x34. No way to change!
Manual Intervention Register
Program-Counter Register

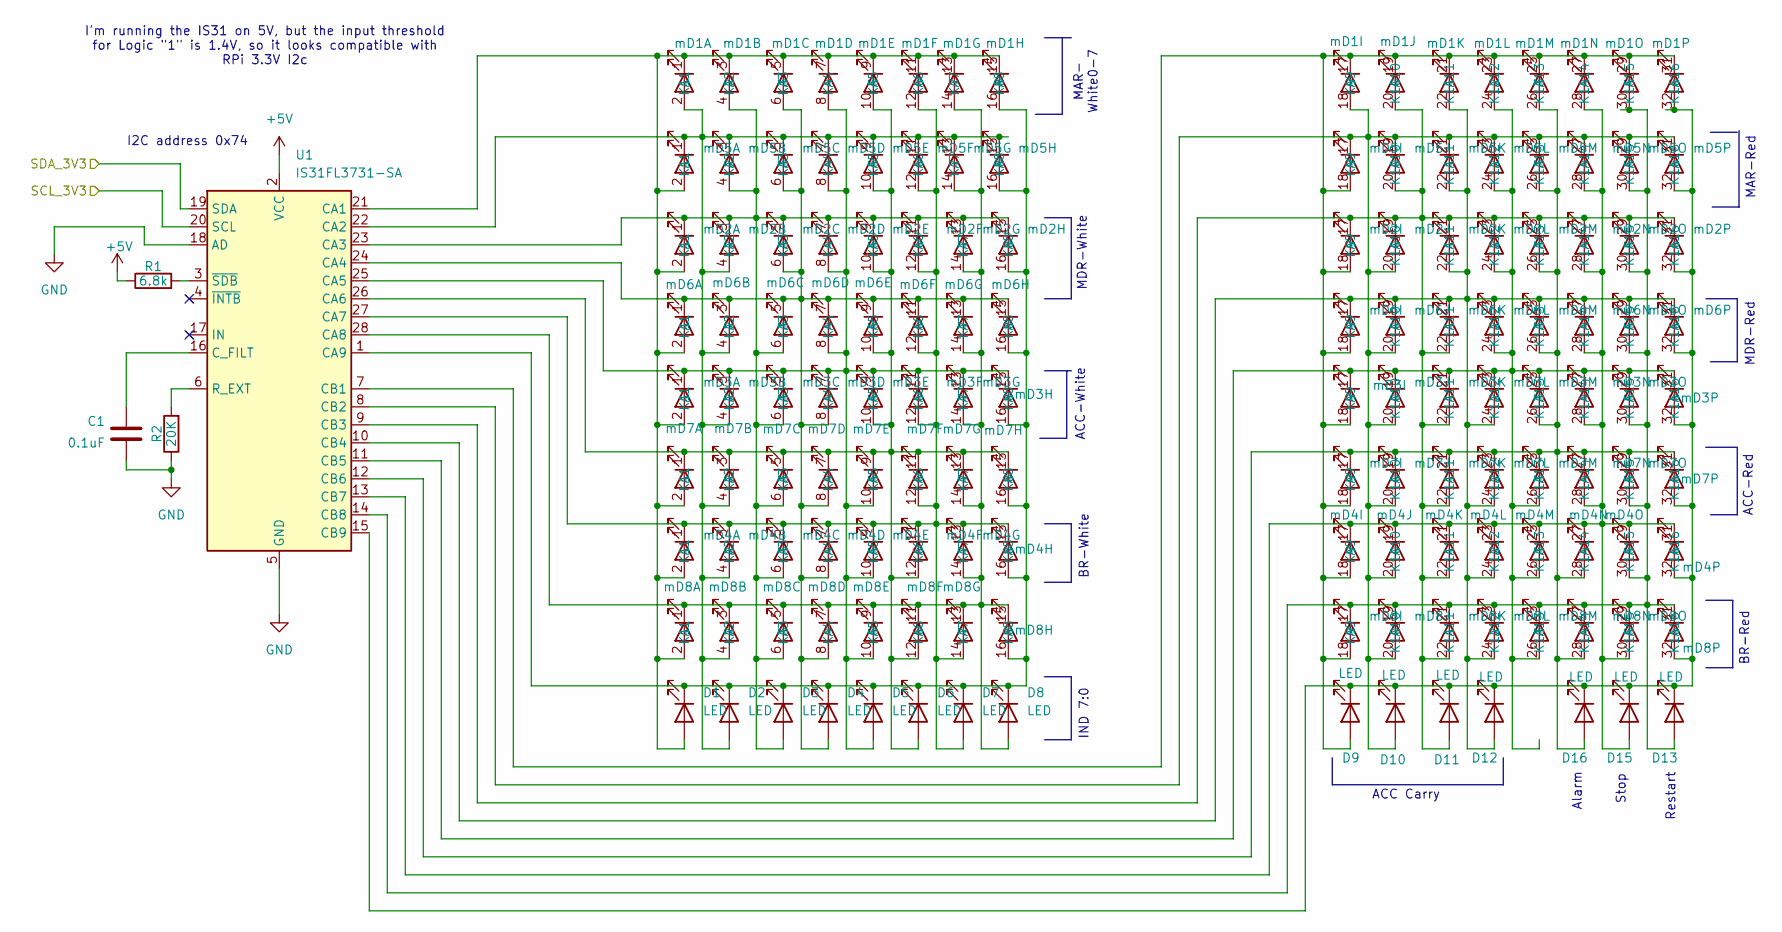
[picture p14: schematic AR-BR-MDR-Registers.kicad_sch]

Parts:
C1: 0.1uF; C_Rect_L7.0mm_W2.5mm_P5.00mm
D1, D2, D3, D4, D5, D6, D7, D8, D9, D10, D11, D12, D13, D15: LED; LED_D3.0mm
D16: LED; LED_D5.0mm
R1: 6.8k; SM-1206B
R2: 20K; SM-1206B
U1: IS31FL3731-SA; SSOP-28_5.3x10.2mm_P0.65mm
mD1, mD2, mD3, mD4, mD5, mD6, mD7, mD8: LED_D3.0mm_16x_bank

Connections:
+5V: R1.1, U1.2 (VCC); also elsewhere on the board
/SCL_3V3: U1.20 (SCL); also elsewhere on the board
/SDA_3V3: U1.19 (SDA); also elsewhere on the board
GND: C1.2, R2.1, U1.5 (GND), U1.18 (AD); also elsewhere on the board
unnamed: D1.2 (A), U1.21 (CA1), mD1.1 (K1), mD1.3 (K2), mD1.5 (K3), mD1.7 (K4), mD1.9 (K5), mD1.11 (K6), mD1.13 (K7), mD1.15 (K8), mD2.2 (A1), mD3.2 (A1), mD4.2 (A1), mD5.2 (A1), mD6.2 (A1), mD7.2 (A1), mD8.2 (A1)
unnamed: D1.1 (K), D2.1 (K), D3.1 (K), D4.1 (K), D5.1 (K), D6.1 (K), D7.1 (K), D8.1 (K), U1.1 (CA9), mD1.16 (A8), mD2.16 (A8), mD3.16 (A8), mD4.16 (A8), mD5.16 (A8), mD6.16 (A8), mD7.16 (A8), mD8.16 (A8)
unnamed: D2.2 (A), U1.22 (CA2), mD1.2 (A1), mD2.4 (A2), mD3.4 (A2), mD4.4 (A2), mD5.1 (K1), mD5.3 (K2), mD5.5 (K3), mD5.7 (K4), mD5.9 (K5), mD5.11 (K6), mD5.13 (K7), mD5.15 (K8), mD6.4 (A2), mD7.4 (A2), mD8.4 (A2)
unnamed: D3.2 (A), U1.23 (CA3), mD1.4 (A2), mD2.1 (K1), mD2.3 (K2), mD2.5 (K3), mD2.7 (K4), mD2.9 (K5), mD2.11 (K6), mD2.13 (K7), mD2.15 (K8), mD3.6 (A3), mD4.6 (A3), mD5.4 (A2), mD6.6 (A3), mD7.6 (A3), mD8.6 (A3)
unnamed: D4.2 (A), U1.24 (CA4), mD1.6 (A3), mD2.6 (A3), mD3.8 (A4), mD4.8 (A4), mD5.6 (A3), mD6.1 (K1), mD6.3 (K2), mD6.5 (K3), mD6.7 (K4), mD6.9 (K5), mD6.11 (K6), mD6.13 (K7), mD6.15 (K8), mD7.8 (A4), mD8.8 (A4)
unnamed: D5.2 (A), U1.25 (CA5), mD1.8 (A4), mD2.8 (A4), mD3.1 (K1), mD3.3 (K2), mD3.5 (K3), mD3.7 (K4), mD3.9 (K5), mD3.11 (K6), mD3.13 (K7), mD3.15 (K8), mD4.10 (A5), mD5.8 (A4), mD6.8 (A4), mD7.10 (A5), mD8.10 (A5)
unnamed: D6.2 (A), U1.26 (CA6), mD1.10 (A5), mD2.10 (A5), mD3.10 (A5), mD4.12 (A6), mD5.10 (A5), mD6.10 (A5), mD7.1 (K1), mD7.3 (K2), mD7.5 (K3), mD7.7 (K4), mD7.9 (K5), mD7.11 (K6), mD7.13 (K7), mD7.15 (K8), mD8.12 (A6)
unnamed: D7.2 (A), U1.27 (CA7), mD1.12 (A6), mD2.12 (A6), mD3.12 (A6), mD4.1 (K1), mD4.3 (K2), mD4.5 (K3), mD4.7 (K4), mD4.9 (K5), mD4.11 (K6), mD4.13 (K7), mD4.15 (K8), mD5.12 (A6), mD6.12 (A6), mD7.12 (A6), mD8.14 (A7)
unnamed: D8.2 (A), U1.28 (CA8), mD1.14 (A7), mD2.14 (A7), mD3.14 (A7), mD4.14 (A7), mD5.14 (A7), mD6.14 (A7), mD7.14 (A7), mD8.1 (K1), mD8.3 (K2), mD8.5 (K3), mD8.7 (K4), mD8.9 (K5), mD8.11 (K6), mD8.13 (K7), mD8.15 (K8)
unnamed: D9.2 (A), U1.7 (CB1), mD1.17 (K9), mD1.19 (K10), mD1.21 (K11), mD1.23 (K12), mD1.25 (K13), mD1.27 (K14), mD1.29 (K15), mD1.31 (K16), mD2.18 (A9), mD3.18 (A9), mD4.18 (A9), mD5.18 (A9), mD6.18 (A9), mD7.18 (A9), mD8.18 (A9)
unnamed: D10.2 (A), U1.8 (CB2), mD1.18 (A9), mD2.20 (A10), mD3.20 (A10), mD4.20 (A10), mD5.17 (K9), mD5.19 (K10), mD5.21 (K11), mD5.23 (K12), mD5.25 (K13), mD5.27 (K14), mD5.29 (K15), mD5.31 (K16), mD6.20 (A10), mD7.20 (A10), mD8.20 (A10)
unnamed: D9.1 (K), D10.1 (K), D11.1 (K), D12.1 (K), D13.1 (K), D15.1 (K), D16.1 (K), U1.15 (CB9), mD1.32 (A16), mD2.32 (A16), mD3.32 (A16), mD4.32 (A16), mD5.32 (A16), mD6.32 (A16), mD7.32 (A16), mD8.32 (A16)
unnamed: D11.2 (A), U1.9 (CB3), mD1.20 (A10), mD2.17 (K9), mD2.19 (K10), mD2.21 (K11), mD2.23 (K12), mD2.25 (K13), mD2.27 (K14), mD2.29 (K15), mD2.31 (K16), mD3.22 (A11), mD4.22 (A11), mD5.20 (A10), mD6.22 (A11), mD7.22 (A11), mD8.22 (A11)
unnamed: D12.2 (A), U1.10 (CB4), mD1.22 (A11), mD2.22 (A11), mD3.24 (A12), mD4.24 (A12), mD5.22 (A11), mD6.17 (K9), mD6.19 (K10), mD6.21 (K11), mD6.23 (K12), mD6.25 (K13), mD6.27 (K14), mD6.29 (K15), mD6.31 (K16), mD7.24 (A12), mD8.24 (A12)
unnamed: D13.2 (A), U1.14 (CB8), mD1.30 (A15), mD2.30 (A15), mD3.30 (A15), mD4.30 (A15), mD5.30 (A15), mD6.30 (A15), mD7.30 (A15), mD8.17 (K9), mD8.19 (K10), mD8.21 (K11), mD8.23 (K12), mD8.25 (K13), mD8.27 (K14), mD8.29 (K15), mD8.31 (K16)
unnamed: D15.2 (A), U1.13 (CB7), mD1.28 (A14), mD2.28 (A14), mD3.28 (A14), mD4.17 (K9), mD4.19 (K10), mD4.21 (K11), mD4.23 (K12), mD4.25 (K13), mD4.27 (K14), mD4.29 (K15), mD4.31 (K16), mD5.28 (A14), mD6.28 (A14), mD7.28 (A14), mD8.30 (A15)
unnamed: D16.2 (A), U1.12 (CB6), mD1.26 (A13), mD2.26 (A13), mD3.26 (A13), mD4.28 (A14), mD5.26 (A13), mD6.26 (A13), mD7.17 (K9), mD7.19 (K10), mD7.21 (K11), mD7.23 (K12), mD7.25 (K13), mD7.27 (K14), mD7.29 (K15), mD7.31 (K16), mD8.28 (A14)
unnamed: U1.11 (CB5), mD1.24 (A12), mD2.24 (A12), mD3.17 (K9), mD3.19 (K10), mD3.21 (K11), mD3.23 (K12), mD3.25 (K13), mD3.27 (K14), mD3.29 (K15), mD3.31 (K16), mD4.26 (A13), mD5.24 (A12), mD6.24 (A12), mD7.26 (A13), mD8.26 (A13)
unnamed: C1.1, U1.16 (C_FILT)
unnamed: R2.2, U1.6 (R_EXT)
unnamed: R1.2, U1.3 (~SDB)

Notes on the sheet:
BR-Red
MDR-White
Alarm
MAR-Red
IND 7:0
I'm running the IS31 on 5V, but the input threshold for Logic "1" is 1.4V, so it looks compatible with RPi 3.3V I2c
MAR- White0-7
ACC Carry
Stop
Restart
ACC-Red
BR-White
MDR-Red
I2C address 0x74
ACC-White
