gfedorkow/Micro-Whirlwind/KiCad-PCB/Micro-Whirlwind-Main-PCB - As-Built Dec-2024/Micro-Whirlwind-Main-PCB.kicad_pcb

## KiCad design KiCad-PCB/Micro-Whirlwind-Main-PCB - As-Built Dec-2024/Micro-Whirlwind-Main-PCB.kicad_pcb (continued)

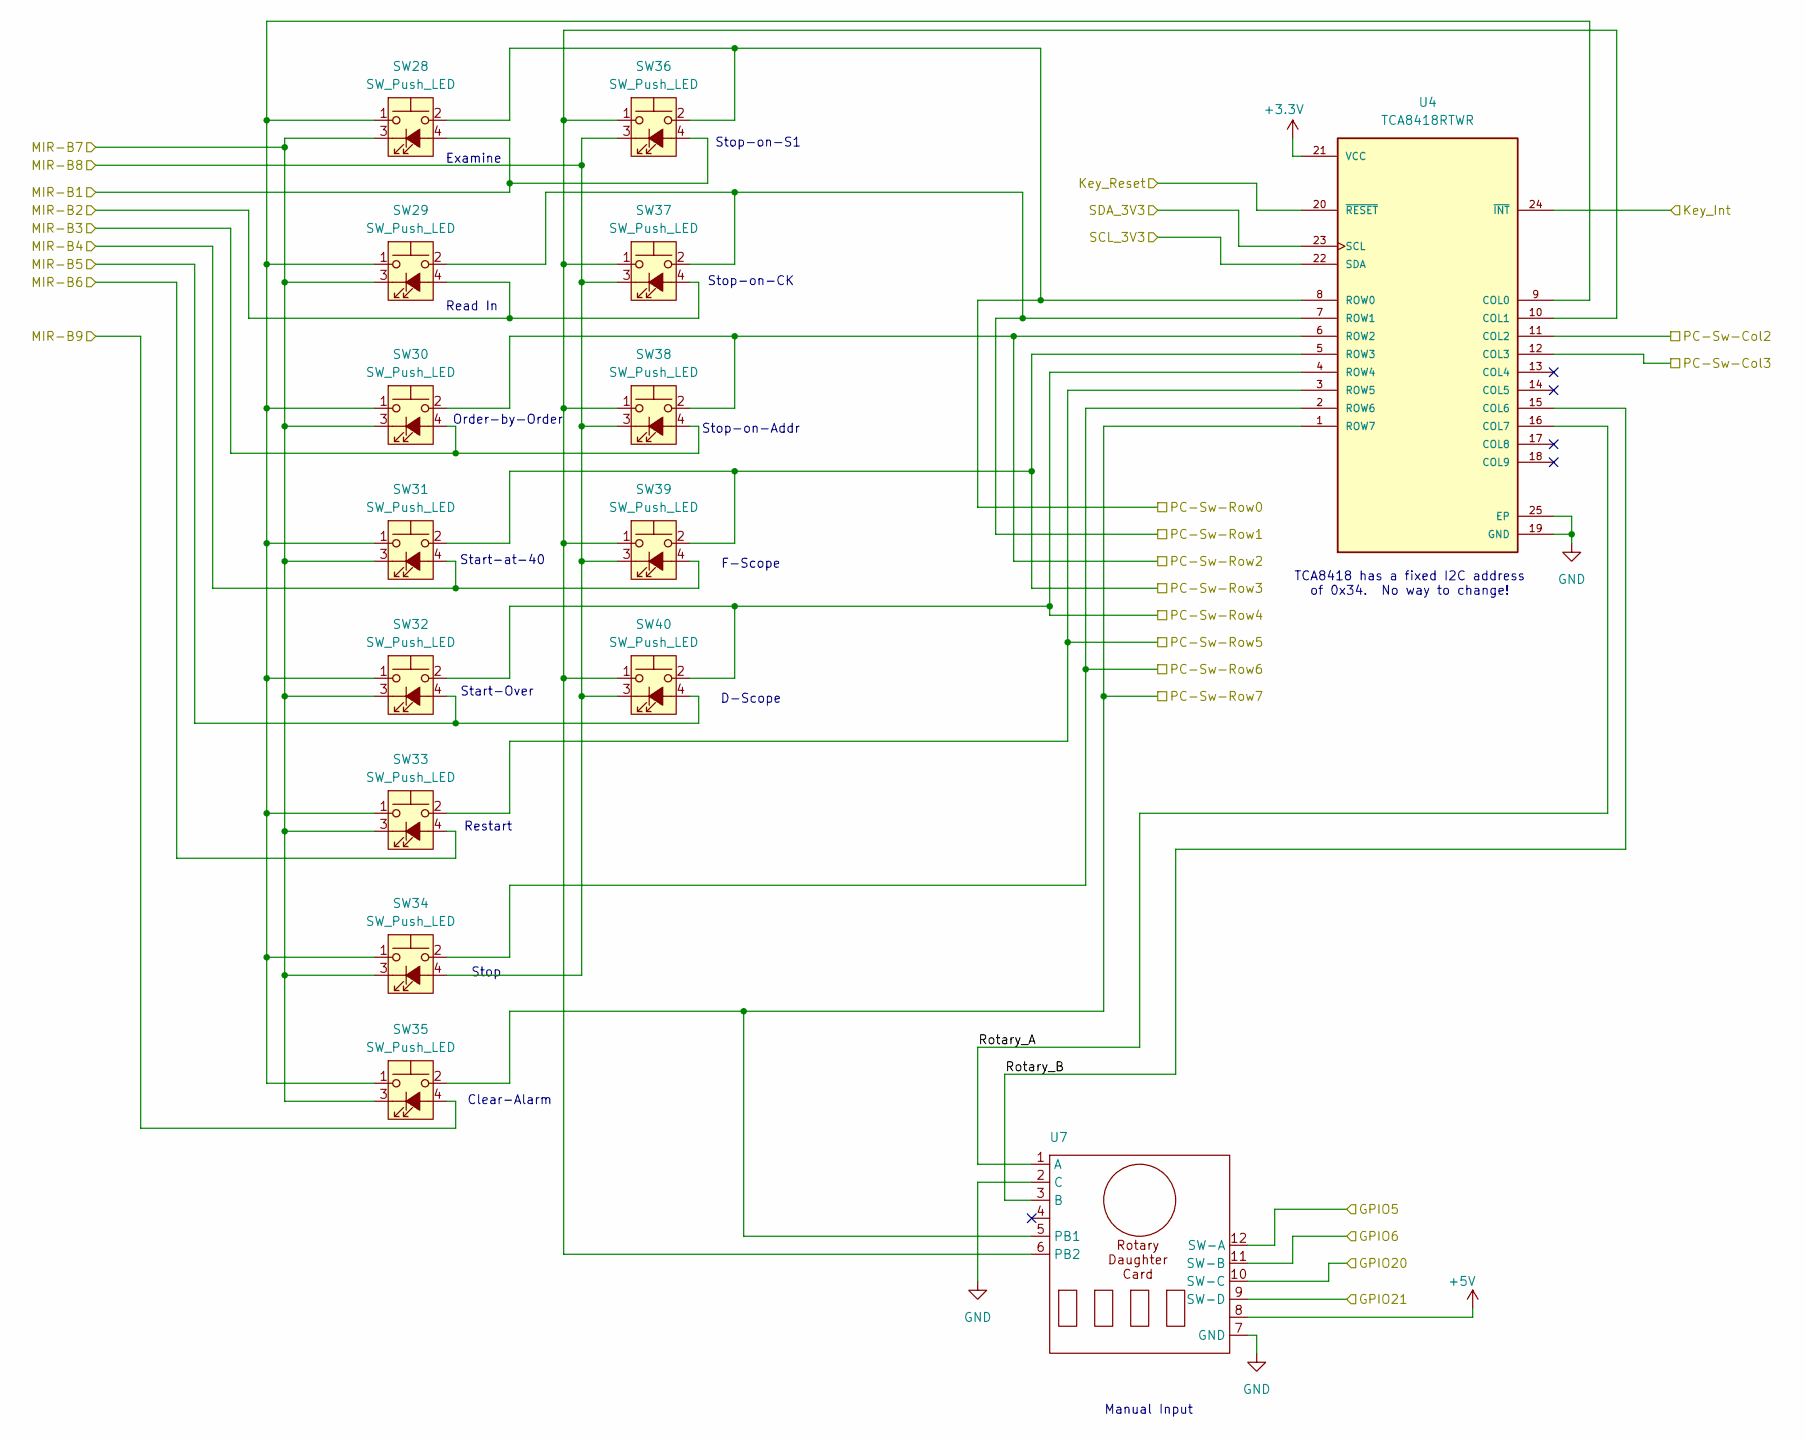
[picture p15: schematic Execution-Control.kicad_sch]

Parts:
SW28, SW29, SW30, SW31, SW32, SW33, SW34, SW35: SW_Push_LED; ILS-TB-140-SW_PUSH_LED_round
SW36, SW37, SW38, SW39, SW40: SW_Push_LED; ILS-TB-140-SW_PUSH_and_LED_6mm
U4: TCA8418RTWR; QFN50P400X400X80-25N; PARTREV G
U7: Rotary-Daughter-PCB

Connections:
+3.3V: U4.21 (VCC); also elsewhere on the board
+5V: U7.8; also elsewhere on the board
/Analog-Scope_Interface/GPIO5: U7.12 (SW-A); also elsewhere on the board
/Analog-Scope_Interface/GPIO6: U7.11 (SW-B); also elsewhere on the board
/Analog-Scope_Interface/GPIO20: U7.10 (SW-C); also elsewhere on the board
/Analog-Scope_Interface/GPIO21: U7.9 (SW-D); also elsewhere on the board
/Execution-Control/PC-Sw-Row0: SW28.2, SW36.2, U4.8 (ROW0); also elsewhere on the board
/Execution-Control/PC-Sw-Row1: SW29.2, SW37.2, U4.7 (ROW1); also elsewhere on the board
/Execution-Control/PC-Sw-Row2: SW30.2, SW38.2, U4.6 (ROW2); also elsewhere on the board
/Execution-Control/PC-Sw-Row3: SW31.2, SW39.2, U4.5 (ROW3); also elsewhere on the board
/Execution-Control/PC-Sw-Row4: SW32.2, SW40.2, U4.4 (ROW4); also elsewhere on the board
/Execution-Control/PC-Sw-Row5: SW33.2, U4.3 (ROW5); also elsewhere on the board
/Execution-Control/PC-Sw-Row6: SW34.2, U4.2 (ROW6); also elsewhere on the board
/Execution-Control/PC-Sw-Row7: SW35.2, U4.1 (ROW7), U7.5 (PB1); also elsewhere on the board
/Execution-Control/Rotary_A: U4.16 (COL7), U7.1 (A)
/Execution-Control/Rotary_B: U4.15 (COL6), U7.3 (B)
/Execution-Control/SCL_3V3: U4.22 (SDA); also elsewhere on the board
/Execution-Control/SDA_3V3: U4.23 (SCL); also elsewhere on the board
/Key_Interrupt: U4.24 (~INT); also elsewhere on the board
/Key_Reset: U4.20 (~RESET); also elsewhere on the board
/MIR-Switches/MIR-B1: SW28.4 (A), SW36.4 (A); also elsewhere on the board
/MIR-Switches/MIR-B2: SW29.4 (A), SW37.4 (A); also elsewhere on the board
/MIR-Switches/MIR-B3: SW30.4 (A), SW38.4 (A); also elsewhere on the board
/MIR-Switches/MIR-B4: SW31.4 (A), SW39.4 (A); also elsewhere on the board
/MIR-Switches/MIR-B5: SW32.4 (A), SW40.4 (A); also elsewhere on the board
/MIR-Switches/MIR-B6: SW33.4 (A); also elsewhere on the board
/MIR-Switches/MIR-B7: SW28.3 (K), SW29.3 (K), SW30.3 (K), SW31.3 (K), SW32.3 (K), SW33.3 (K), SW34.3 (K), SW35.3 (K); also elsewhere on the board
/MIR-Switches/MIR-B8: SW34.4 (A), SW36.3 (K), SW37.3 (K), SW38.3 (K), SW39.3 (K), SW40.3 (K); also elsewhere on the board
/MIR-Switches/MIR-B9: SW35.4 (A); also elsewhere on the board
/MIR-Switches/PC-Sw-Col2: U4.11 (COL2); also elsewhere on the board
/MIR-Switches/PC-Sw-Col3: U4.12 (COL3); also elsewhere on the board
GND: U4.19 (GND), U4.25 (EP), U7.2 (C), U7.7 (GND); also elsewhere on the board
unnamed: SW28.1, SW29.1, SW30.1, SW31.1, SW32.1, SW33.1, SW34.1, SW35.1, U4.9 (COL0)
unnamed: SW36.1, SW37.1, SW38.1, SW39.1, SW40.1, U4.10 (COL1), U7.6 (PB2)

Notes on the sheet:
F-Scope
Manual Input
Start-Over
Stop-on-S1
Read In
Start-at-40
TCA8418 has a fixed I2C address of 0x34. No way to change!
Stop-on-Addr
Stop-on-CK
Stop
Clear-Alarm
Examine
Restart
Order-by-Order
D-Scope

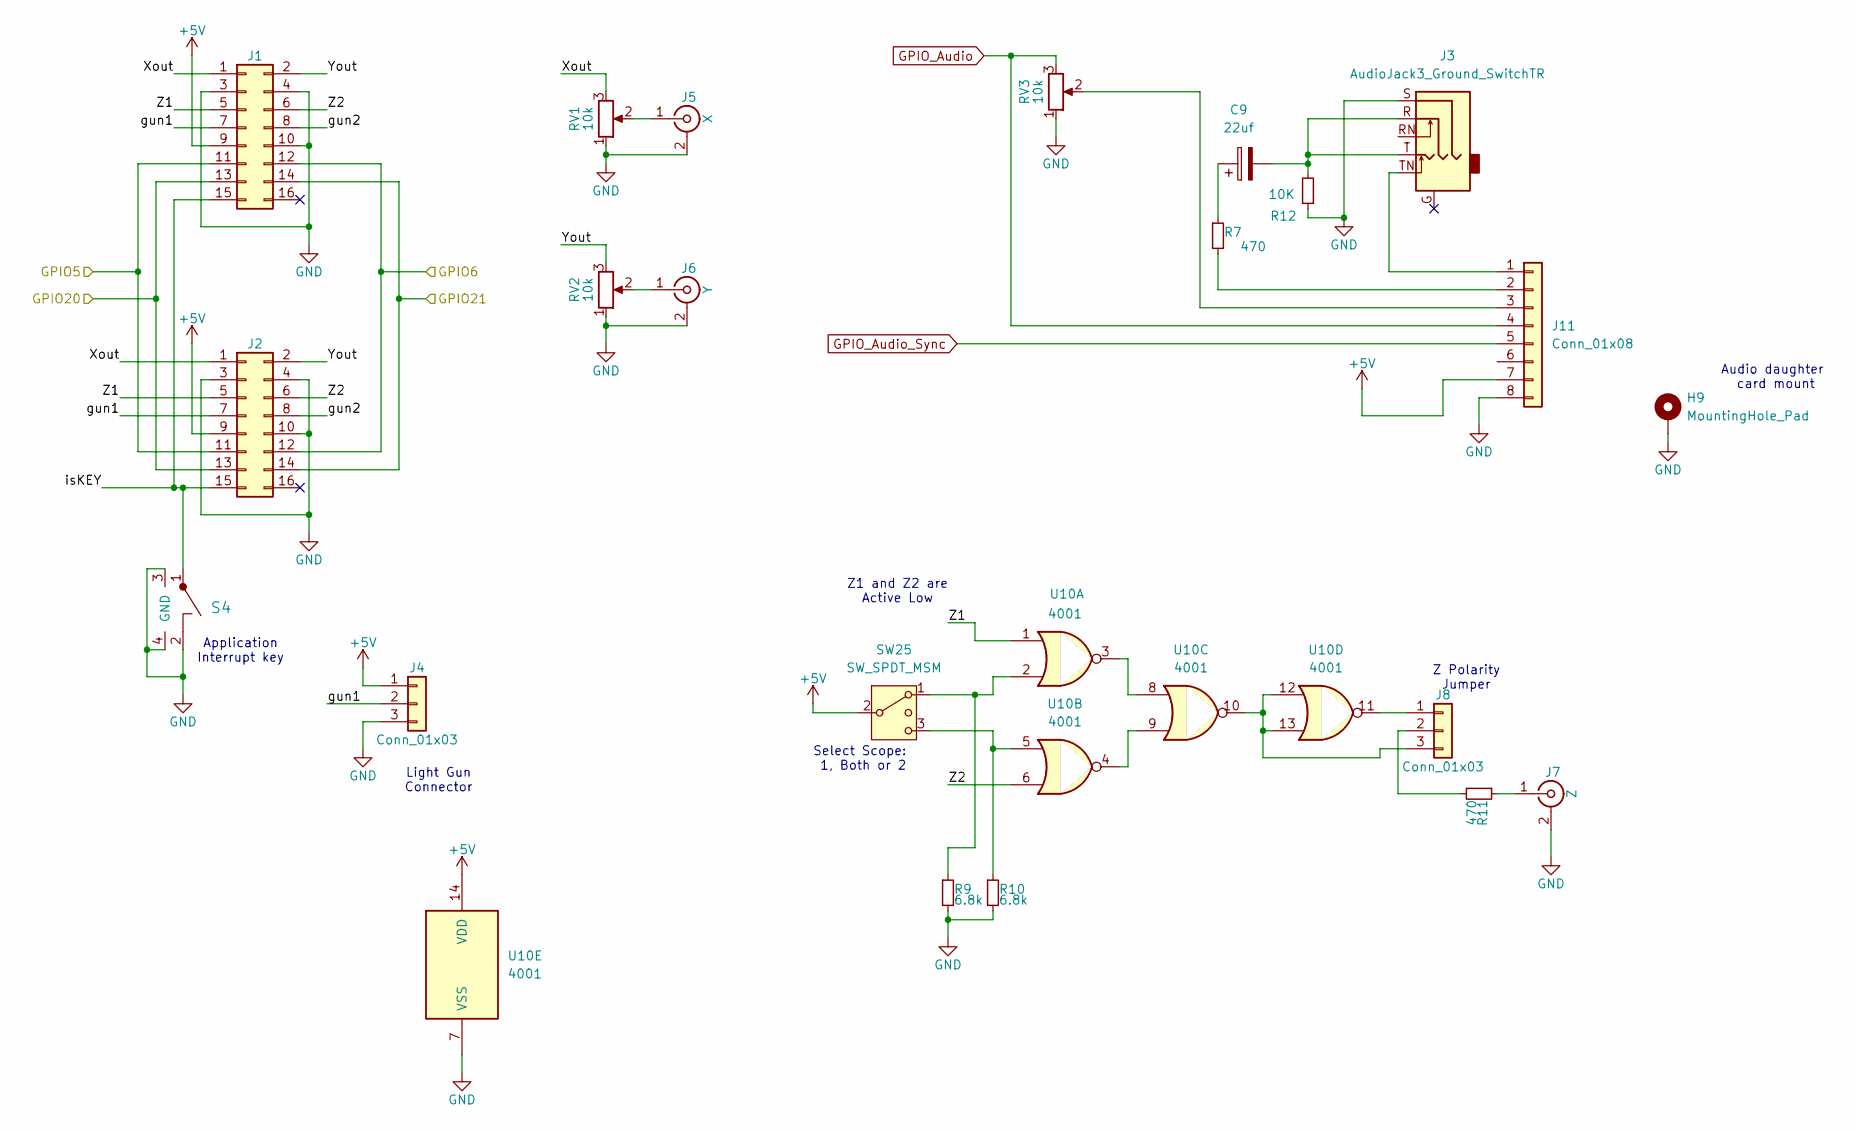
[picture p16: schematic Analog-Scope_Interface.kicad_sch]

Parts:
C9: 22uf; CP_Radial_D5.0mm_P2.50mm
H9: MountingHole_Pad; MountingHole_3.2mm_M3_DIN965_Pad_TopBottom
J1: Conn_02x08_Odd_Even; IDC-Header_2x08_P2.54mm_Horizontal
J2: Conn_02x08_Odd_Even; IDC-Header_2x08_P2.54mm_Vertical
J3: AudioJack3_Ground_SwitchTR; Jack_3.5mm_CUI_SJ1-3535NG_Horizontal
J4, J8: Conn_01x03; PSS_3
J5: X; CUI_RCJ-041
J6: Y; CUI_RCJ-041
J7: Z; CUI_RCJ-041
J11: Conn_01x08; PinHeader_1x08_P2.54mm_Vertical
R7, R11: 470; SM-1206B
R9, R10: 6.8k; SM-1206B
R12: 10K; SM-1206B
RV1, RV2, RV3: 10k; Potentiometer_Bourns_PTV09A-2_Single_Horizontal
S4: RA_Push; SW_KSA0V311LFTR_CNK-RA-pushbutton
SW25: SW_SPDT_MSM; SPDT-Toggle-Right-Angle
U10: 4001; SOIC-14_3.9x8.7mm_P1.27mm

Connections:
+5V: J1.9, J2.9, J4.1, J11.7, SW25.2 (3), U10.14 (VDD); also elsewhere on the board
/Analog-Scope_Interface/GPIO5: J1.11, J2.11; also elsewhere on the board
/Analog-Scope_Interface/GPIO6: J1.12, J2.12; also elsewhere on the board
/Analog-Scope_Interface/GPIO20: J1.13, J2.13; also elsewhere on the board
/Analog-Scope_Interface/GPIO21: J1.14, J2.14; also elsewhere on the board
/Analog-Scope_Interface/Xout: J1.1, J2.1, RV1.3
/Analog-Scope_Interface/Yout: J1.2, J2.2, RV2.3
/Analog-Scope_Interface/Z1: J1.5, J2.5, U10.1
/Analog-Scope_Interface/Z2: J1.6, J2.6, U10.6
/Analog-Scope_Interface/gun1: J1.7, J2.7, J4.2
/Analog-Scope_Interface/gun2: J1.8, J2.8
/Analog-Scope_Interface/isKEY: J1.15, J2.15, S4.1
GND: H9.1, J1.3, J1.4, J1.10, J2.3, J2.4, J2.10, J3.S, J4.3, J5.2 (Ext), J6.2 (Ext), J7.2 (Ext), J11.8, R9.2, R10.2, R12.1, RV1.1, RV2.1, RV3.1, S4.2, S4.3 (GND), S4.4, U10.7 (VSS); also elsewhere on the board
GPIO_Audio: J11.4, RV3.3
GPIO_Audio_Sync: J11.5
unnamed: C9.1, R7.1
unnamed: C9.2, J3.R, J3.T, R12.2
unnamed: J5.1 (In), RV1.2
unnamed: J6.1 (In), RV2.2
unnamed: J7.1 (In), R11.1
unnamed: J8.1, U10.11
unnamed: J8.2, R11.2
unnamed: J8.3, U10.10, U10.12, U10.13
unnamed: J3.TN, J11.1
unnamed: J11.2, R7.2
unnamed: J11.3, RV3.2
unnamed: R9.1, SW25.1, U10.2
unnamed: R10.1, SW25.3 (4), U10.5
unnamed: U10.3, U10.8
unnamed: U10.4, U10.9

Notes on the sheet:
Light Gun Connector
Z Polarity Jumper
Application Interrupt key
Z1 and Z2 are Active Low
Select Scope: 1, Both or 2
Audio daughter card mount

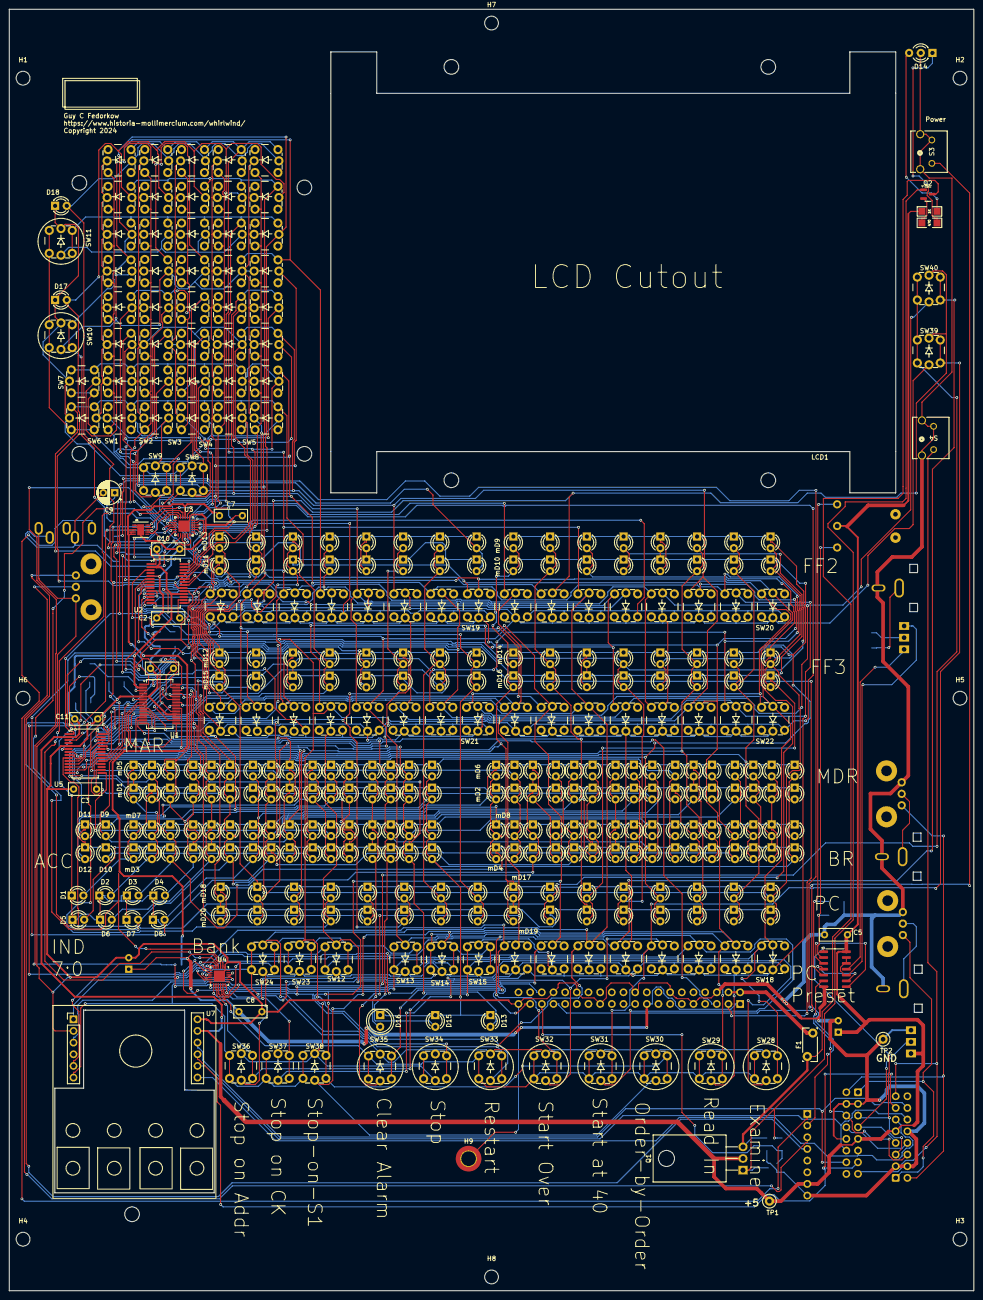
[picture p17: board Micro-Whirlwind-Main-PCB.kicad_pcb from above]

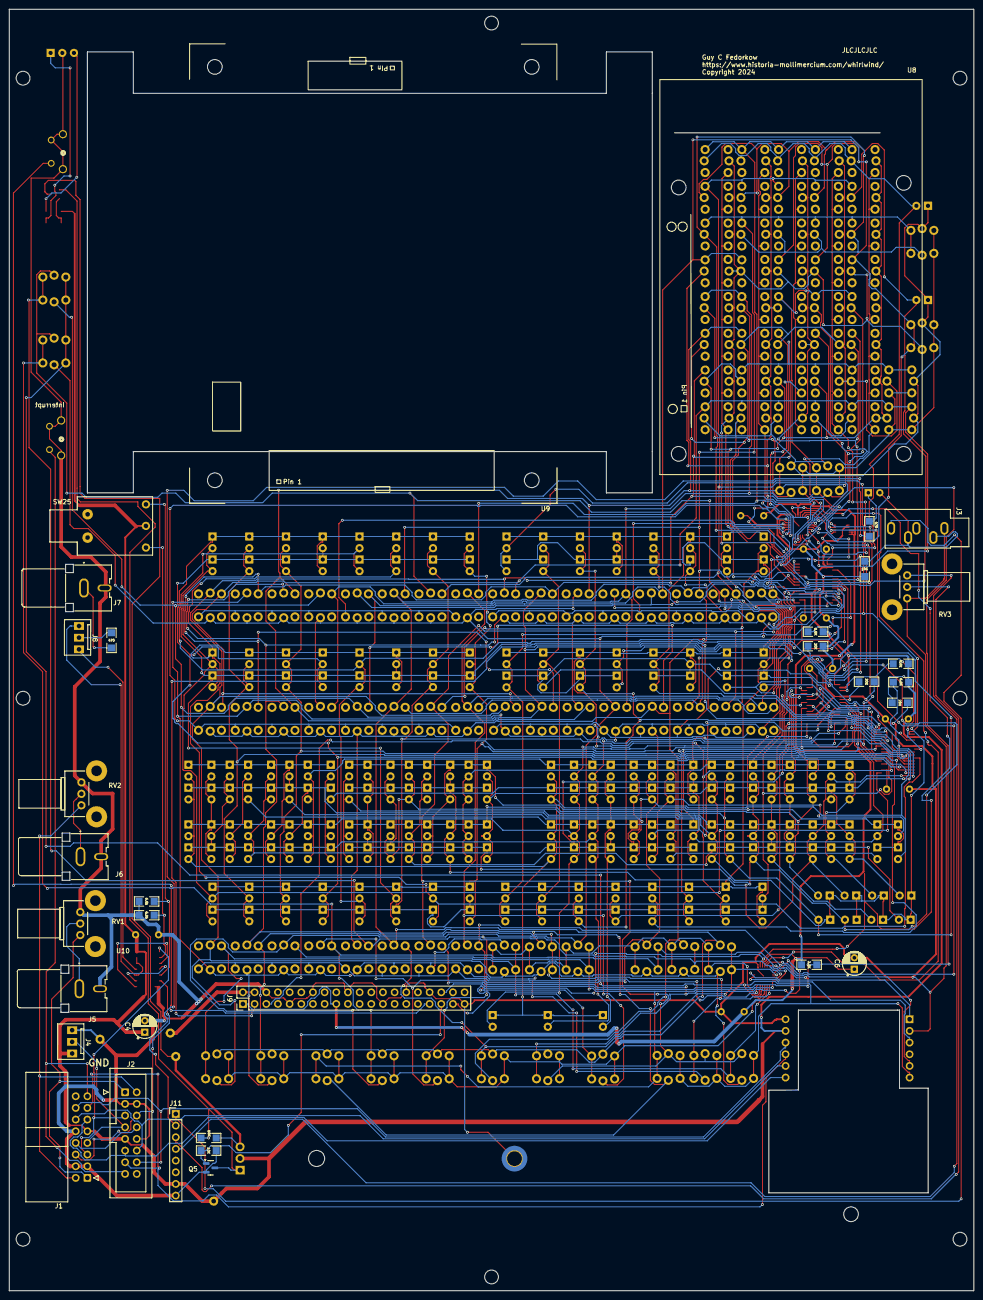
[picture p18: board Micro-Whirlwind-Main-PCB.kicad_pcb from below]

Board: 2 copper layers, 210.0 x 279.0 mm, 143 parts (21 on the bottom side), 139 nets.
