gfedorkow/Micro-Whirlwind/KiCad-PCB/Micro-Whirlwind-Rotary-Daughter/Micro-Whirlwind-Rotary-Daughter.kicad_pcb

## KiCad design KiCad-PCB/Micro-Whirlwind-Rotary-Daughter/Micro-Whirlwind-Rotary-Daughter.kicad_pcb (2025-10-29)

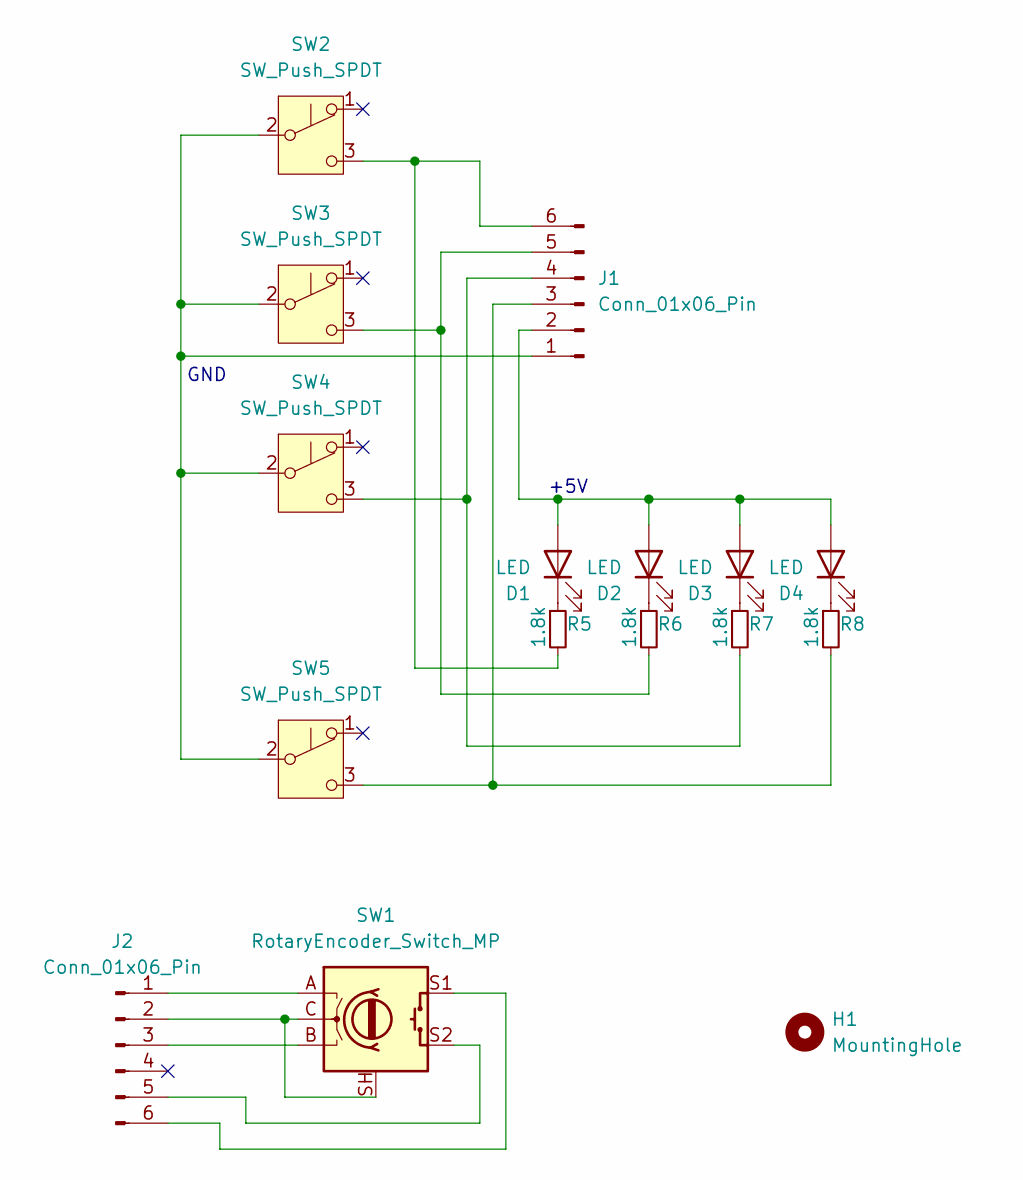
[picture p19: schematic Micro-Whirlwind-Rotary-Daughter.kicad_sch, Rotary Encoder Daughter Card]

Parts:
D1, D2, D3, D4: LED; LED_D3.0mm
H1: MountingHole; MountingHole_3.2mm_M3
J1, J2: Conn_01x06_Pin; PinHeader_1x06_P2.54mm_Vertical
R5, R6, R7, R8: 1.8k; R_1206_3216Metric_Pad1.30x1.75mm_HandSolder
SW1: RotaryEncoder_Switch_MP; RotaryEncoder_Bourns_Vertical_PEC12R-3x17F-Sxxxx
SW2, SW3, SW4, SW5: SW_Push_SPDT; PinHeader_1x03_P2.54mm_Vertical

Connections:
unnamed: D1.2 (A), D2.2 (A), D3.2 (A), D4.2 (A), J1.2
unnamed: D1.1 (K), R5.1
unnamed: D2.1 (K), R6.1
unnamed: D3.1 (K), R7.1
unnamed: D4.1 (K), R8.1
unnamed: J1.1, SW2.2 (B), SW3.2 (B), SW4.2 (B), SW5.2 (B)
unnamed: J1.3, R8.2, SW5.3 (C)
unnamed: J1.4, R7.2, SW4.3 (C)
unnamed: J1.5, R6.2, SW3.3 (C)
unnamed: J1.6, R5.2, SW2.3 (C)
unnamed: J2.1, SW1.A
unnamed: J2.2, SW1.C, SW1.SH
unnamed: J2.3, SW1.B
unnamed: J2.5, SW1.S2
unnamed: J2.6, SW1.S1

Notes on the sheet:
GND
+5V

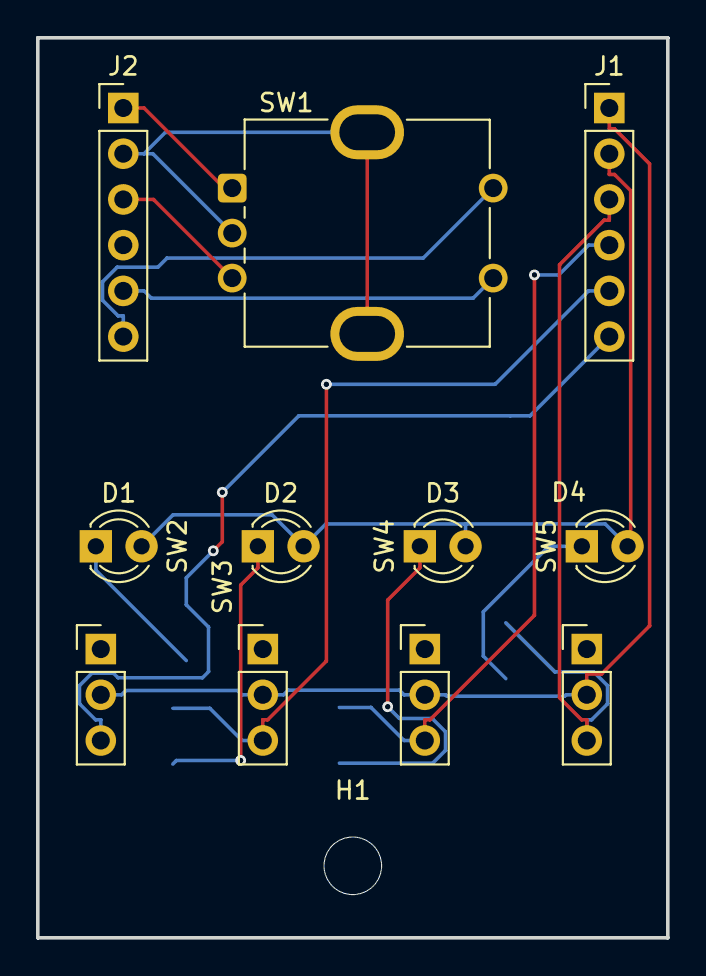
[picture p20: board Micro-Whirlwind-Rotary-Daughter.kicad_pcb from above]

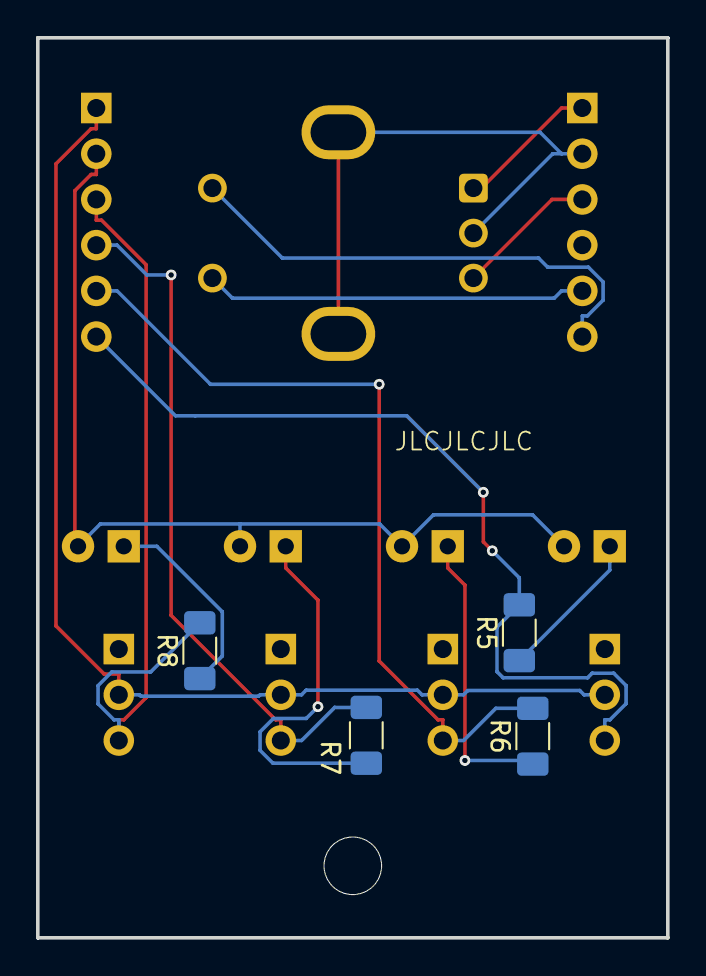
[picture p21: board Micro-Whirlwind-Rotary-Daughter.kicad_pcb from below]

Board: 2 copper layers, 35.0 x 50.0 mm, 16 parts (4 on the bottom side), 15 nets.
