gfedorkow/Micro-Whirlwind/KiCad-PCB/Micro-Whirlwind-PoC-Board/Micro-Whirlwind-PoC-PCB.kicad_pcb

## KiCad design KiCad-PCB/Micro-Whirlwind-PoC-Board/Micro-Whirlwind-PoC-PCB.kicad_pcb (2025-10-29)

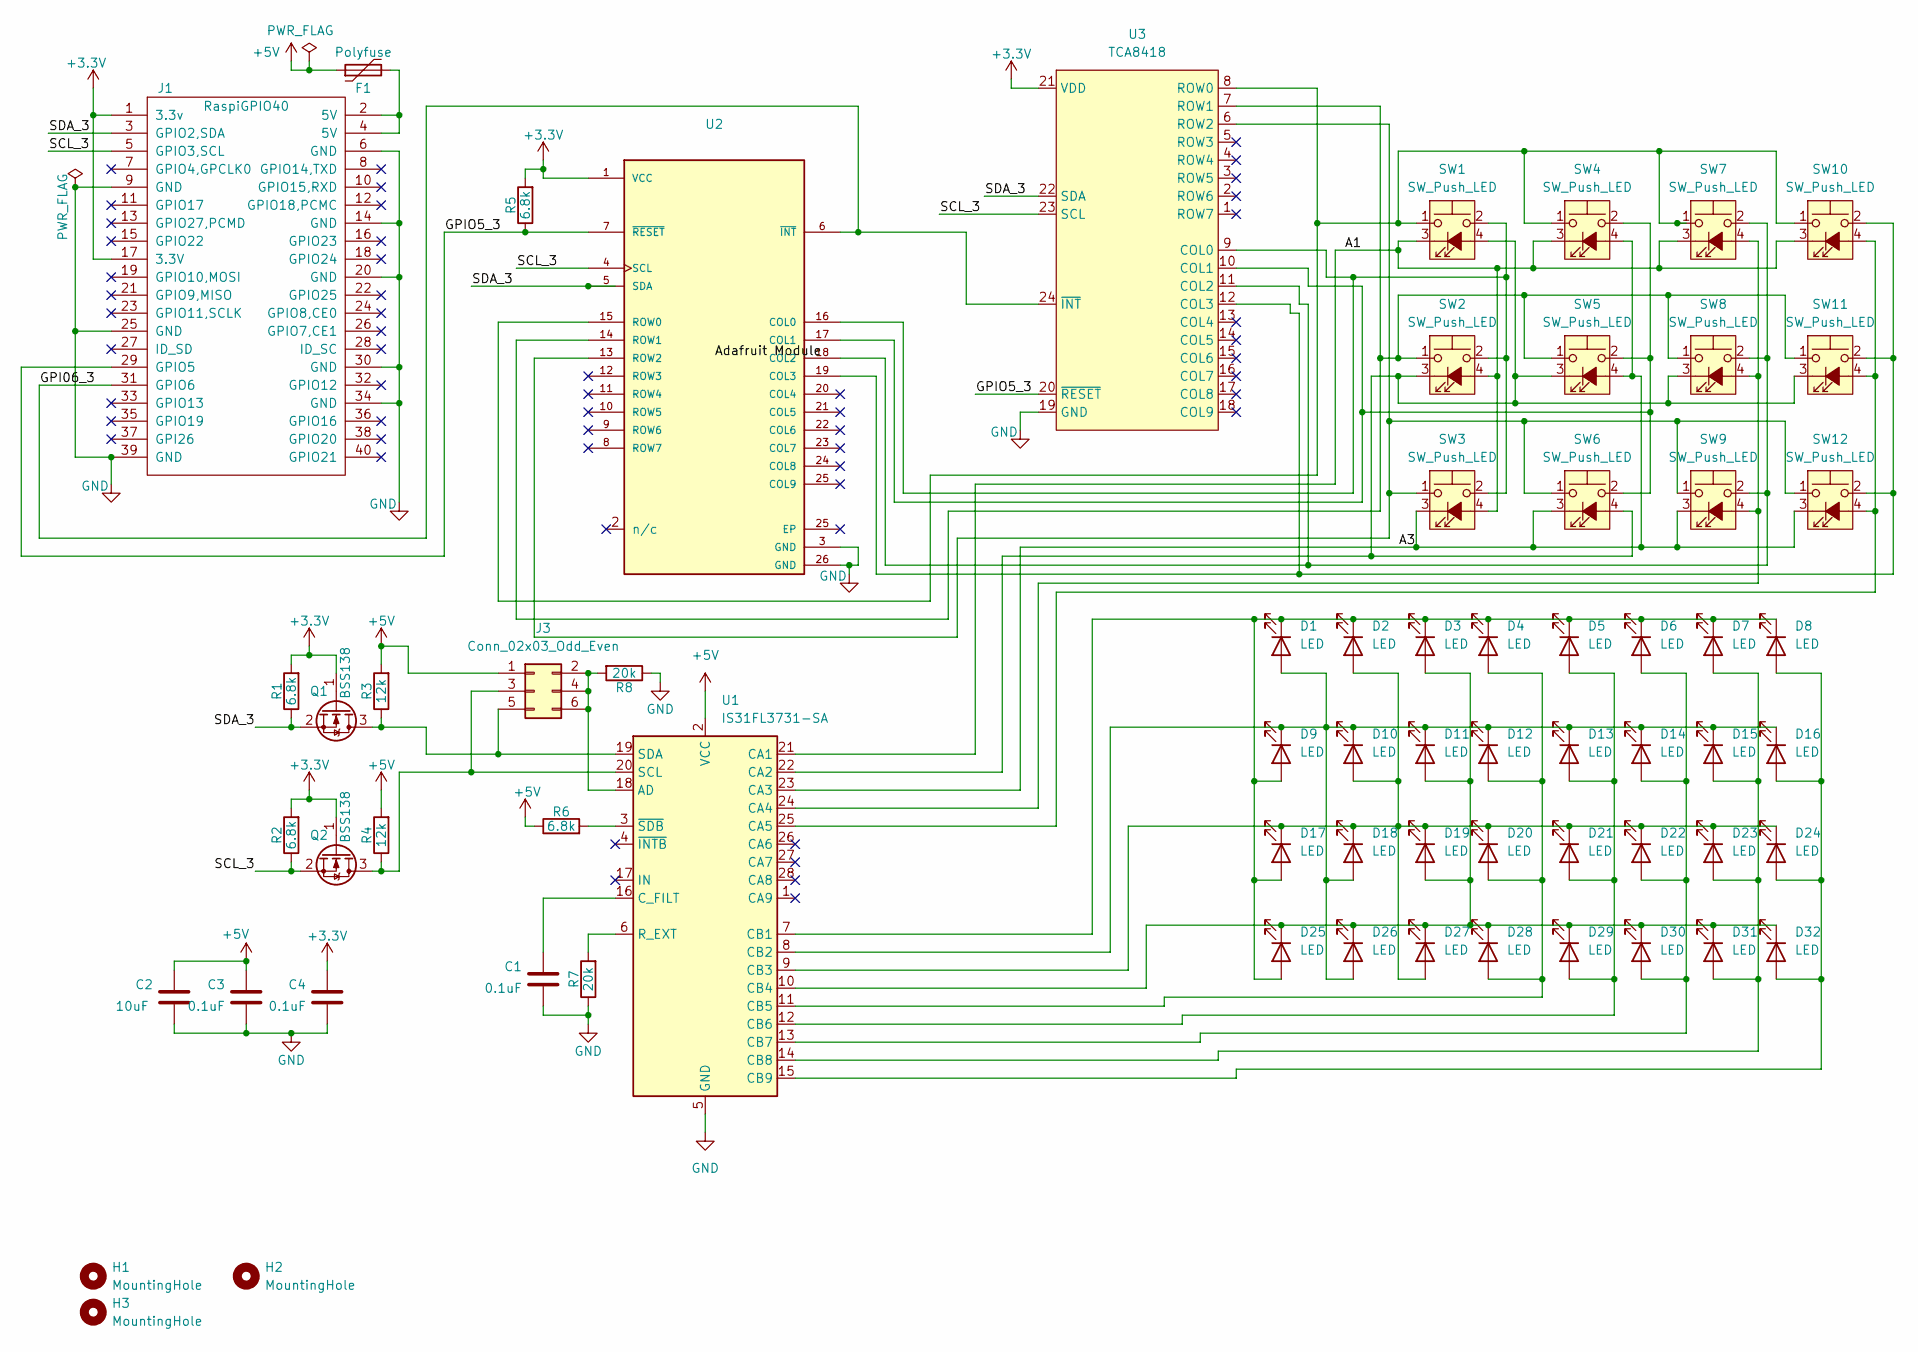
[picture p22: schematic Micro-Whirlwind-PoC-PCB.kicad_sch]

Parts:
C1, C3, C4: 0.1uF; C_Rect_L11.0mm_W2.8mm_P10.00mm_MKT
C2: 10uF; CP_Radial_D5.0mm_P2.50mm
D1, D2, D3, D4, D5, D6, D7, D8, D9, D10, D11, D12, D13, D14, D15, D16, D17, D18, D19, D20, D21, D22, D23, D24, D25, D26, D27, D28, D29, D30, D31, D32: LED; LED_D3.0mm
F1: Polyfuse; Fuse_Bourns_MF-RG300
H1, H2, H3: MountingHole; MountingHole_2.5mm_panel_cut
J1: RaspiGPIO40; Wannenstecker_2x20_V
J3: Conn_02x03_Odd_Even; PinHeader_2x03_P2.54mm_Vertical
Q1, Q2: BSS138; SOT-23
R1, R2, R5, R6: 6.8k; SM-1206B
R3, R4: 12k; SM-1206B
R7, R8: 20k; SM-1206B
SW1, SW2, SW3, SW4, SW5, SW6, SW7, SW8, SW9, SW10, SW11, SW12: SW_Push_LED; SW_PUSH_and_LED_6mm_H8mm
U1: IS31FL3731-SA; SSOP-28_5.3x10.2mm_P0.65mm
U2: TCA8418RTWR-Module; AdaFruit_2x13_header; PARTREV G
U3: TCA8418; WQFN-24-1EP_4x4mm_P0.5mm_EP2.45x2.45mm

Connections:
+3.3V: C4.1, J1.1 (3.3v), J1.17 (3.3V), Q1.1 (G), Q2.1 (G), R1.2, R2.2, R5.2, U2.1 (VCC), U3.21 (VDD)
+5V: C2.1, C3.1, F1.1, J3.1, R3.2, R4.2, R6.1, U1.2 (VCC)
/A1: SW1.3 (K), SW2.4 (A), SW3.4 (A), SW4.3 (K), SW7.3 (K), SW10.3 (K), U1.21 (CA1)
/A3: SW3.3 (K), SW4.4 (A), SW5.4 (A), SW6.3 (K), SW9.3 (K), SW12.3 (K), U1.23 (CA3)
/GPI06_3: J1.31 (GPIO6), U2.6 (~INT), U3.24 (~INT)
/GPIO5_3: J1.29 (GPIO5), R5.1, U2.7 (~RESET), U3.20 (~RESET)
/SCL_3: J1.5 (GPIO3,SCL), Q2.2 (S), R2.1, U2.4 (SCL), U3.23 (SCL)
/SDA_3: J1.3 (GPIO2,SDA), Q1.2 (S), R1.1, U2.5 (SDA), U3.22 (SDA)
GND: C1.2, C2.2, C3.2, C4.2, J1.6 (GND), J1.9 (GND), J1.14 (GND), J1.20 (GND), J1.25 (GND), J1.30 (GND), J1.34 (GND), J1.39 (GND), R7.1, R8.1, U1.5 (GND), U2.3 (GND), U2.26 (GND), U3.19 (GND)
unnamed: D1.2 (A), D9.1 (K), D10.1 (K), D11.1 (K), D12.1 (K), D13.1 (K), D14.1 (K), D15.1 (K), D16.1 (K), D18.2 (A), D26.2 (A), U1.8 (CB2)
unnamed: D1.1 (K), D2.1 (K), D3.1 (K), D4.1 (K), D5.1 (K), D6.1 (K), D7.1 (K), D8.1 (K), D9.2 (A), D17.2 (A), D25.2 (A), U1.7 (CB1)
unnamed: D2.2 (A), D10.2 (A), D17.1 (K), D18.1 (K), D19.1 (K), D20.1 (K), D21.1 (K), D22.1 (K), D23.1 (K), D24.1 (K), D27.2 (A), U1.9 (CB3)
unnamed: D3.2 (A), D11.2 (A), D19.2 (A), D25.1 (K), D26.1 (K), D27.1 (K), D28.1 (K), D29.1 (K), D30.1 (K), D31.1 (K), D32.1 (K), U1.10 (CB4)
unnamed: D4.2 (A), D12.2 (A), D20.2 (A), D28.2 (A), U1.11 (CB5)
unnamed: D5.2 (A), D13.2 (A), D21.2 (A), D29.2 (A), U1.12 (CB6)
unnamed: D6.2 (A), D14.2 (A), D22.2 (A), D30.2 (A), U1.13 (CB7)
unnamed: D7.2 (A), D15.2 (A), D23.2 (A), D31.2 (A), U1.14 (CB8)
unnamed: D8.2 (A), D16.2 (A), D24.2 (A), D32.2 (A), U1.15 (CB9)
unnamed: F1.2, J1.2 (5V), J1.4 (5V)
unnamed: J3.2, J3.4, J3.6, R8.2, U1.18 (AD)
unnamed: J3.3, Q2.3 (D), R4.1, U1.20 (SCL)
unnamed: J3.5, Q1.3 (D), R3.1, U1.19 (SDA)
unnamed: SW1.4 (A), SW2.3 (K), SW5.3 (K), SW6.4 (A), SW8.3 (K), SW11.3 (K), U1.22 (CA2)
unnamed: SW7.4 (A), SW8.4 (A), SW9.4 (A), U1.24 (CA4)
unnamed: SW10.4 (A), SW11.4 (A), SW12.4 (A), U1.25 (CA5)
unnamed: C1.1, U1.16 (C_FILT)
unnamed: R7.2, U1.6 (R_EXT)
unnamed: R6.2, U1.3 (~SDB)
unnamed: SW1.2, SW2.2, SW3.2, U2.16 (COL0), U3.9 (COL0)
unnamed: SW4.2, SW5.2, SW6.2, U2.17 (COL1), U3.10 (COL1)
unnamed: SW7.2, SW8.2, SW9.2, U2.18 (COL2), U3.11 (COL2)
unnamed: SW10.2, SW11.2, SW12.2, U2.19 (COL3), U3.12 (COL3)
unnamed: SW1.1, SW4.1, SW7.1, SW10.1, U2.15 (ROW0), U3.8 (ROW0)
unnamed: SW2.1, SW5.1, SW8.1, SW11.1, U2.14 (ROW1), U3.7 (ROW1)
unnamed: SW3.1, SW6.1, SW9.1, SW12.1, U2.13 (ROW2), U3.6 (ROW2)

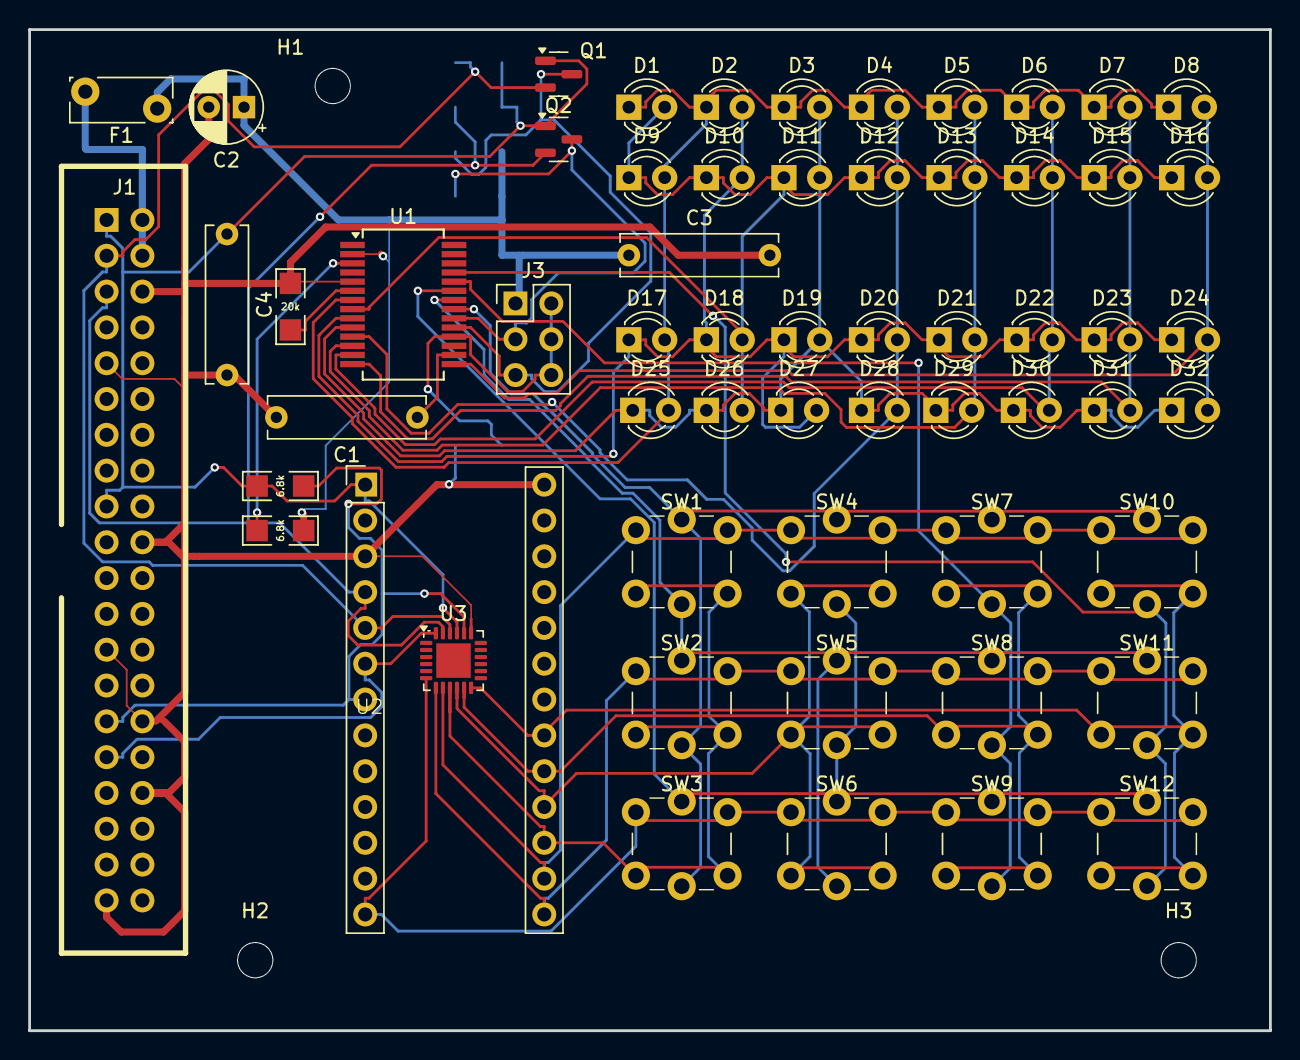
[picture p23: board Micro-Whirlwind-PoC-PCB.kicad_pcb from above]

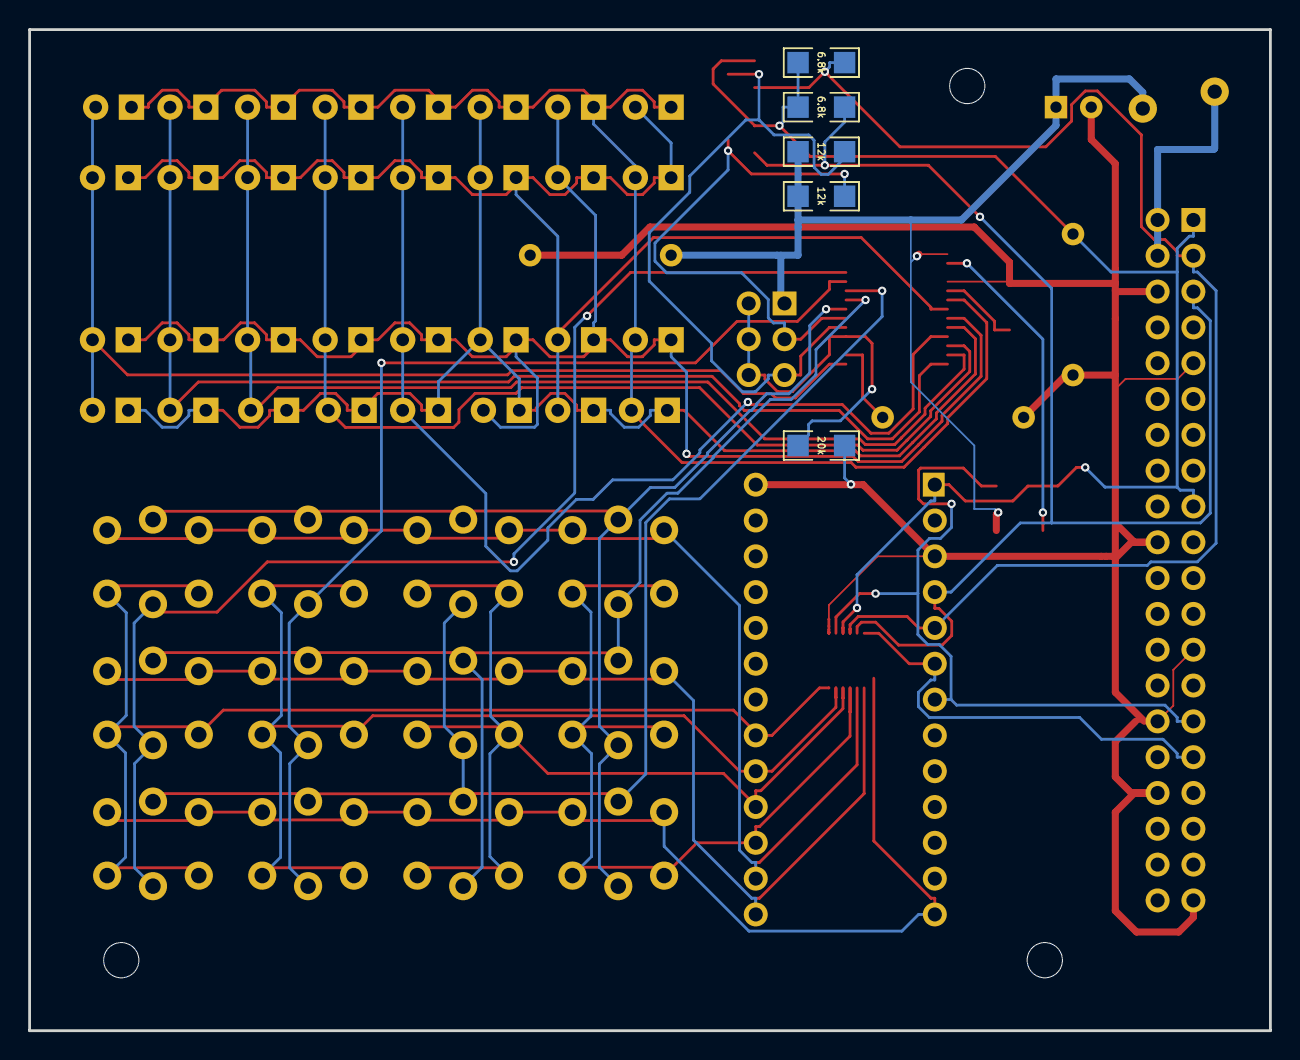
[picture p24: board Micro-Whirlwind-PoC-PCB.kicad_pcb from below]

Board: 2 copper layers, 88.0 x 71.0 mm, 67 parts (3 on the bottom side), 35 nets.
