gfedorkow/Micro-Whirlwind/KiCad-PCB/Test-Boards/IFL-Mux-Demo-Test-PCB/IS31-Mux-Demo-Test-PCB/IS31-Mux-Demo.kicad_sch

## KiCad design KiCad-PCB/Test-Boards/IFL-Mux-Demo-Test-PCB/IS31-Mux-Demo-Test-PCB/IS31-Mux-Demo.kicad_sch (2025-10-29)

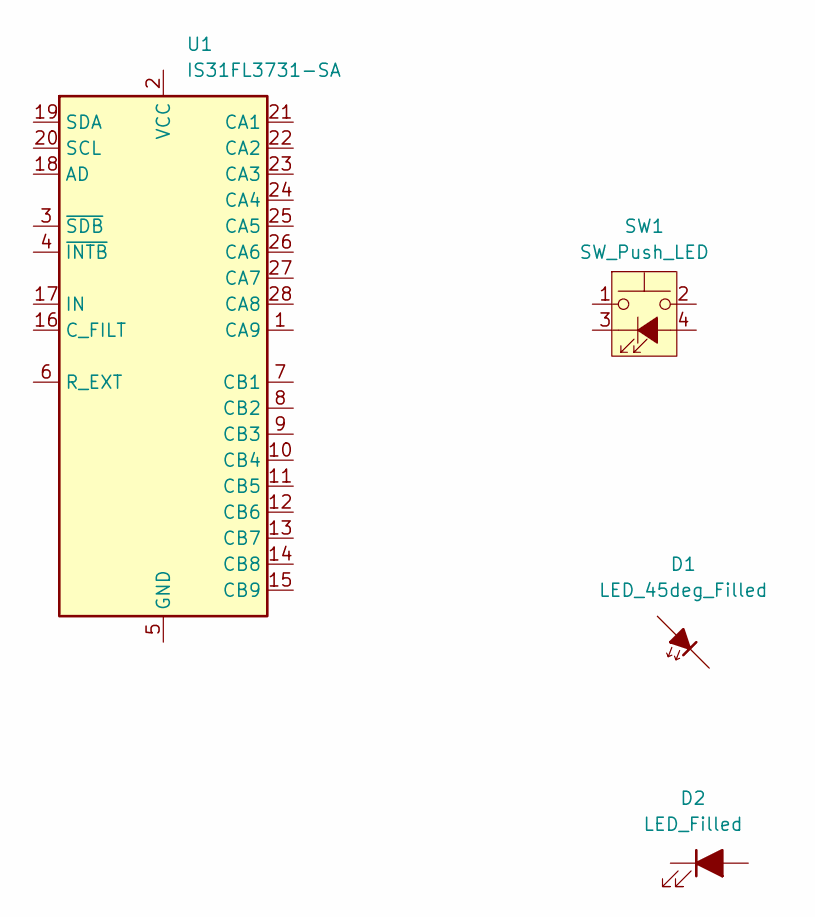
[picture p25: schematic IS31-Mux-Demo.kicad_sch]

Parts:
D1: LED_45deg_Filled
D2: LED_Filled
SW1: SW_Push_LED
U1: IS31FL3731-SA; SSOP-28_5.3x10.2mm_P0.65mm
