gfedorkow/Micro-Whirlwind/(commit log)

2025-10-29 re-initializing Micro-Whirlwind repository
    [AR-BR-MDR-Registers.kicad_sch, Adafruit IS31FL3731 CharliePlex Grid.brd, Adafruit IS31FL3731 CharliePlex Grid.sch, Analog-Scope_Interface.kicad_sch, BoM-for-test-pcb.xlsx, Execution-Control.kicad_sch, FF-and-PC-Registers.kicad_sch, IS31-Mux-Demo.kicad_pcb]
2025-12-25 revised and tweaked Notes on PCB Corrections
2025-12-31 I made most of the corrections to the schematic and some to the PCB. The Main PCB needs to be redone with a four-layer PCB, so I didn't re-route all the traces on the PCB The Power switch needs to be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
    [AR-BR-MDR-Registers.kicad_sch, Analog-Scope_Interface.kicad_sch, Execution-Control.kicad_sch, FF-and-PC-Registers.kicad_sch, MIR-Switches.kicad_sch, Micro-Whirlwind-Main-PCB-BoM.csv, Micro-Whirlwind-Main-PCB-BoM.xlsx, Micro-Whirlwind-Main-PCB-guy.xlsx]
2026-03-06 routine update of Notes files
    [RasPi5-New-SD-Configuration.txt]
2026-06-15 added one new LED to indicate that the Light Gun is active. See page 'Execution Control'
    [Execution-Control.kicad_sch]
