gfedorkow/Micro-Whirlwind/(notices)

Notices in the files:
KiCad-PCB/Micro-Whirlwind-Main-PCB - As-Built Dec-2024/Micro-Whirlwind-Main-PCB.kicad_pcb:
Copyright 2024
